Gurjas2112/CHOTU/bot_3d_printing/review_report.md

# Automatic FDM design review - CHOTU v3

Generated by `tools/cad_pipeline.py` after every build (checklist from the Towards AI *cad-skill* workflow: watertight, bed fit, flat bottom, wall thickness, overhangs).

| Part | Qty | Size (mm) | Watertight | Bed fit | Flat bottom (mm²) | Overhang >45° (mm²) | Supports | Est. PETG (g) | Est. time (h) | Result |
|---|---|---|---|---|---|---|---|---|---|---|
| bumper_front | 1 | 51×217×174 | ✔ | ✔ | 427 | 323 | 2627 | yes (see note) | 80 | 7.3 | PASS |
| bumper_left | 1 | 217×51×174 | ✔ | ✔ | 427 | 99 | 2578 | none | 83 | 7.5 | PASS |
| bumper_rear | 1 | 51×217×174 | ✔ | ✔ | 427 | 113 | 2651 | none | 82 | 7.5 | PASS |
| bumper_right | 1 | 217×51×174 | ✔ | ✔ | 427 | 99 | 2578 | none | 83 | 7.5 | PASS |
| lid_tile_1 | 1 | 150×150×3 | ✔ | ✔ | 12193 | 0 | 0 | none | 46 | 4.2 | PASS |
| lid_tile_2 | 1 | 150×150×4 | ✔ | ✔ | 15933 | 0 | 0 | none | 61 | 5.5 | PASS |
| lid_tile_3 | 1 | 150×150×3 | ✔ | ✔ | 15933 | 0 | 0 | none | 61 | 5.5 | PASS |
| lid_tile_4 | 1 | 150×150×3 | ✔ | ✔ | 12193 | 0 | 0 | none | 46 | 4.2 | PASS |
| suction_nozzle | 1 | 36×200×39 | ✔ | ✔ | 1232 | 0 | 2148 | none | 28 | 2.6 | PASS |
| dust_bin | 1 | 100×90×70 | ✔ | ✔ | 8057 | 61 | 4 | none | 43 | 3.9 | PASS |
| bin_filter_lid | 1 | 100×90×28 | ✔ | ✔ | 568 | 0 | 8182 | none | 26 | 2.4 | PASS |
| bin_cradle | 1 | 104×113×40 | ✔ | ✔ | 1127 | 78 | 0 | none | 31 | 2.8 | PASS |
| motor_bracket_left | 1 | 40×48×21 | ✔ | ✔ | 1502 | 14 | 905 | none | 9 | 0.8 | PASS |
| motor_bracket_right | 1 | 40×48×21 | ✔ | ✔ | 1502 | 14 | 905 | none | 9 | 0.8 | PASS |
| caster_spacer | 1 | 32×32×18 | ✔ | ✔ | 695 | 0 | 0 | none | 12 | 1.1 | PASS |
| side_brush_mount | 1 | 30×30×26 | ✔ | ✔ | 882 | 0 | 18 | none | 12 | 1.1 | PASS |
| cliff_mount_left | 1 | 16×36×22 | ✔ | ✔ | 567 | 0 | 0 | none | 6 | 0.5 | PASS |
| cliff_mount_right | 1 | 16×36×22 | ✔ | ✔ | 567 | 0 | 0 | none | 6 | 0.5 | PASS |
| battery_tray | 1 | 76×61×12 | ✔ | ✔ | 4440 | 0 | 240 | none | 18 | 1.6 | PASS |
| camera_pod | 1 | 26×32×26 | ✔ | ✔ | 569 | 112 | 114 | none | 14 | 1.2 | PASS |
| deck_pillar_1 | 1 | 12×12×40 | ✔ | ✔ | 75 | 8 | 0 | none | 4 | 0.4 | PASS |
| deck_pillar_2 | 1 | 12×12×40 | ✔ | ✔ | 75 | 8 | 0 | none | 4 | 0.4 | PASS |
| deck_pillar_3 | 1 | 12×12×40 | ✔ | ✔ | 75 | 8 | 0 | none | 4 | 0.4 | PASS |
| deck_pillar_4 | 1 | 12×12×40 | ✔ | ✔ | 75 | 8 | 0 | none | 4 | 0.4 | PASS |
| electronics_deck | 1 | 100×160×9 | ✔ | ✔ | 14840 | 0 | 27 | none | 60 | 5.4 | PASS |
| bin_hatch | 1 | 117×107×5 | ✔ | ✔ | 10169 | 0 | 168 | none | 57 | 5.2 | PASS |
| rear_skid | 1 | 18×18×34 | ✔ | ✔ | 245 | 0 | 9 | none | 7 | 0.6 | PASS |
| dock_station | 1 | 90×200×110 | ✔ | ✔ | 18000 | 10 | 61 | none | 110 | 10.0 | PASS |

**Totals:** 28 printed parts, ≈ 1007 g PETG (≈ ₹1007 at ₹1/g), ≈ 92 h on a 0.4 mm nozzle at 0.2 mm layers.

All parts pass: **True**. *Bridges* are flat ceilings designed to span less than 20 mm (printable without supports). *Steep overhang* is surface between 45 deg and horizontal: on `bumper_front` it is the upper half of the six 16.6 mm transducer holes and the ToF window, which print cleanly without supports at 0.2 mm layers.
