Gurjas2112/CHOTU/docs/ARCHITECTURE.md

# CHOTU v3: System Architecture

## 1. Block diagram

```mermaid
flowchart LR
  subgraph Power["Power - 3S4P Li-ion 11.1 V / 10 Ah (111 Wh) + 3S BMS"]
    BATT[Battery pack] --> FUSE[Fuse + switch]
    FUSE --> BUCK5[5 V / 5 A buck<br/>Raspberry Pi 4]
    FUSE --> TB[TB6612FNG motor driver]
    FUSE --> MOS1[IRLZ44N - vacuum]
    FUSE --> MOS2[IRLZ44N - side brushes]
  end

  subgraph Pi["Raspberry Pi 4 (4 GB) - ROS 2 Humble in Docker"]
    BRIDGE[serial_bridge_node<br/>odom + TF + sensor topics]
    MISSION[mission_manager_node<br/>chotu_core.CleaningMission]
    YOLO[yolo_detector_node<br/>YOLOv8n suck/avoid]
    CAM[v4l2_camera]
    CAM --> YOLO --> MISSION
    BRIDGE --> MISSION --> BRIDGE
  end

  subgraph MCU["ESP32-S3 DevKitC-1 - real-time base controller (50 Hz)"]
    PID[Wheel PID + feed-forward]
    SAFE[Safety supervisor<br/>watchdog / bump / cliff / ToF]
    SENS[Sensor drivers]
  end

  BRIDGE <-- "UART 115200<br/>COBS + CRC16" --> MCU
  PID --> TB --> MOT[2x BO gear motor<br/>+ 20-slot encoders]
  MOT -- ticks --> PID
  SAFE --> MOS1 --> VAC[Bergmann tornado<br/>12 V vacuum]
  SAFE --> MOS2 --> BRUSH[Brush motors]
  US[3x HC-SR04] --> SENS
  TOF[VL53L0X ToF] --> SENS
  IMU[MPU6050 gyro] --> SENS
  BUMP[SW-420 bump] --> SENS
  CLIFF[2x TCRT5000 cliff] --> SENS
  DOCKIR[TSOP38238 dock IR] --> SENS
  PICAM[Pi camera 5 MP] --> CAM

  subgraph Clients["Off-robot (demo data today)"]
    APP[Flutter app]
    API[FastAPI fleet backend<br/>+ PostgreSQL]
  end
  APP <-- "rosbridge v2 JSON<br/>ws://pi:9090" --> Pi
  API <-- "rosbridge v2 JSON" --> Pi
  APP <-- "REST + WebSocket /api/v1" --> API
```

All the robot's autonomy runs on board. The app and the backend are clients. If WiFi or the backend fails, the mission still completes and the robot still docks.

## 2. Software layers

| Layer | Where | Rate | Code |
|---|---|---|---|
| Motor PWM, encoder ISR, wheel PID, ultrasonic ISR, safety watchdog | ESP32-S3 | 50 Hz (ISRs async) | `firmware/esp32s3_base_controller/src/main.cpp` |
| Wire protocol, PID, safety rules (host-testable) | ESP32-S3 + host g++ | – | `firmware/.../lib/chotu_logic/src/chotu_logic.h` |
| Serial bridge, odometry (encoder + gyro), TF, sensor topics | Pi 4 | 50 Hz | `ros2_ws/src/chotu_base` |
| Mission FSM, mapping, coverage, A*, reactive safety, adaptive suction | Pi 4 | 20 Hz | `chotu_core/*` via `chotu_navigation/mission_manager_node.py` |
| Suck/avoid detection + floor projection | Pi 4 (CPU, NCNN) / RTX 3060 (CUDA) | 5 FPS | `chotu_core/perception.py`, `chotu_perception` |
| Gazebo world (physics simulation) + recorder | Workstation (Docker) | 500 Hz physics | `chotu_gazebo`, `chotu_bringup/launch/sim.launch.py`, `bot_simulation/gazebo_recording/` |
| App API (start / dock / no-go zones / status) | Pi 4 | 5 Hz status | `rosbridge_websocket` in `robot.launch.py` |
| Mobile app (control, live map, schedules, history) | Phone | – | `mobile_app/chotu_app` (Flutter) |
| Fleet backend (history, schedules, zones, alerts, live relay) | Server / workstation | 1 Hz relay | `backend/chotu_api` (FastAPI + SQLAlchemy) |

## 3. Mission state machine

```mermaid
stateDiagram-v2
  [*] --> IDLE
  IDLE --> UNDOCK: /chotu/start_mission
  UNDOCK --> SCAN: 0.45 m from dock
  SCAN --> COVER: 360 deg sweep done
  COVER --> SPOT_CLEAN: lane waypoints exhausted
  COVER --> STUCK_RECOVERY: blocked > 1.5 s / no progress 5 s
  SPOT_CLEAN --> STUCK_RECOVERY
  STUCK_RECOVERY --> COVER: reverse + VFH turn
  STUCK_RECOVERY --> SPOT_CLEAN
  COVER --> RETURN_TO_DOCK: time_left < ETA + margin / low battery / app "Dock"
  SPOT_CLEAN --> RETURN_TO_DOCK: room complete / time
  RETURN_TO_DOCK --> DOCKING: at approach point
  DOCKING --> DOCKED: contacts (< 3 cm)
  DOCKED --> [*]
```

## 4. Autonomy algorithms (chotu_core)

* **Odometry** (`kinematics.py`). The encoders are single-channel, so direction comes from the command sign. Heading is fused with the MPU6050 gyro (complementary filter, 0.98 gyro). The gyro bias is calibrated on the dock at boot.
* **Mapping** (`occupancy_grid.py`). A 5 cm log-odds grid. HC-SR04 echoes are integrated over their **15° cone** (three rays). The cone edges carry weaker free-space evidence, so thin chair legs survive. Echoes explained by the **known room walls** are not mapped. The camera's *avoid* detections become permanent keep-out discs.
* **Coverage** (`coverage_planner.py`, `autonomy.py`). Boustrophedon lanes 22 cm apart give 2 cm of overlap for a 24 cm head. The next waypoint is picked greedily with an anisotropic cost (along-lane 1, lane change 2.5, reversing +0.6). That finishes the region the robot is in before crossing over, which works like an online cell decomposition. Leftover pockets are found with connected components (*frontier fill*).
* **Planning** (`path_planner.py`). 8-connected A* on a two-tier map: **hard** cells are physically impossible, **soft** cells are the clearance band. Soft cells are allowed only inside an *escape disc* around the robot, so it can always plan its way out but is never routed between chair legs. Paths are string-pulled for line of sight.
* **Reactive safety** (`obstacle_avoidance.py`). Every echo is projected onto the round chassis' swept corridor. A wall *beside* the robot no longer blocks it, but a chair leg *ahead* does. The firmware enforces the same stop rules independently.
* **Time-aware return.** Every second the robot plans an A* path home and estimates the ETA at 75 % of top speed. It leaves for the dock when `time_left < ETA + 14 s`.
* **User no-go zones** (`autonomy.add_no_go`, `OccupancyGrid.mark_rect`). Rectangles drawn in the app arrive through `/chotu/set_zones` and become permanent keep-out cells. They are excluded from coverage and avoided by A*.
* **Operator dock** (`autonomy.request_dock`). The app's *Dock* button is `StartMission{abort: true}`. From any cleaning state the robot plans home with A* and finishes with the normal IR docking.
* **Adaptive suction** (`suction_controller.py`). ECO is 55 % and BOOST is 100 % for 1.2 s after debris is detected ahead. Fan power scales with duty^1.5.

## 5. Pi ↔ ESP32 protocol

Each frame is `COBS(payload ‖ CRC16-CCITT) ‖ 0x00`, where the payload is `msg_id:u8, seq:u8, body` (little-endian).

| ID | Direction | Body |
|---|---|---|
| `0x01` CMD_VEL | Pi → ESP | `i16 v_mm_s, i16 w_mrad_s` |
| `0x02` ACTUATORS | Pi → ESP | `u8 suction_pct, u8 brush_pct` |
| `0x03` HEARTBEAT | Pi → ESP | – (feeds the 300 ms watchdog) |
| `0x04` ESTOP | Pi → ESP | `u8 engage` |
| `0x81` TELEMETRY | ESP → Pi | `u32 t_ms, i32 ticks_l, i32 ticks_r, i16 gyro_z_mrad_s, u16 us_l, us_c, us_r, tof (mm), u8 flags, u16 batt_mv` (25 B) |

The flag bits are bump (0), cliff L (1), cliff R (2), e-stop (3), watchdog (4) and dock IR seen (5). Python (`chotu_core/protocol.py`) and C++ (`chotu_logic.h`) are tested against the **same byte vectors**.

## 6. ESP32-S3 DevKitC-1 pin map

| Function | GPIO | Notes |
|---|---|---|
| TB6612FNG PWMA / AIN1 / AIN2 (left) | 4 / 5 / 6 | 20 kHz, 10-bit PWM |
| TB6612FNG PWMB / BIN1 / BIN2 (right) | 7 / 15 / 16 | |
| TB6612FNG STBY | 2 | LOW = both channels off. A 10 k pull-down keeps the motors off at boot, and e-stop drives it LOW. |
| Encoder L / R | 17 / 18 | LM393 slot sensor, 20 slots, **5 V → 1 k / 2 k divider on the PCB** |
| I2C SDA / SCL | 8 / 9 | VL53L0X (0x29) + MPU6050 (0x68), 400 kHz |
| VL53L0X XSHUT | 47 | |
| HC-SR04 L trig/echo | 10 / 13 | **echo is 5 V → 1k/2k divider** |
| HC-SR04 C trig/echo | 11 / 14 | |
| HC-SR04 R trig/echo | 12 / 21 | |
| SW-420 bump | 38 | interrupt, rising edge |
| Cliff IR L / R | 39 / 40 | HIGH = no floor |
| Dock IR (TSOP38238) | 3 | LOW = 38 kHz beacon seen (input only, so the strapping function is unaffected) |
| Vacuum MOSFET / Brush MOSFET | 41 / 42 | IRLZ44N logic-level, 100 Ω gate, 10 k pull-down, 1N5822 flyback |
| Battery sense | 1 | 100 k / 22 k divider (ADC1) |
| Status LED | 48 | On-board RGB |

We avoided strapping pins 0, 45 and 46 (GPIO3 is used only as an input), USB (19/20), flash and PSRAM (26–37) and UART0 (43/44, the Pi link). The XIAO ESP32-S3 Sense from the original spec sheet has only 11 GPIO, which is too few for this sensor set without an I/O expander. It is retired in v3.

The carrier PCB in `hardware/pcb/` implements exactly this table. `tests/test_pcb_netlist.py` fails if the PCB and `pins.h` ever disagree.

## 7. ROS 2 graph

```
/camera/image_raw ─► yolo_detector_node ─► /chotu/detections ─┐
serial_bridge_node ─► /odom /imu /range/{left,center,right,tof} /chotu/bump /chotu/cliff /battery_state ─► mission_manager_node
mission_manager_node ─► /cmd_vel /chotu/actuators ─► serial_bridge_node ─► ESP32
mission_manager_node ─► /chotu/status /map /chotu/plan  (RViz, dashboards)
services: /chotu/start_mission (StartMission: abort=false starts, abort=true returns to dock)
          /chotu/set_zones     (SetZones: no-go rectangles from the app)
rosbridge_websocket :9090 ─► Flutter app, fleet backend (JSON over WebSocket)
```

In Gazebo, `gz_sensor_adapter_node` replaces `serial_bridge_node` and publishes the **same topics**. The mission node does not know whether it is running in simulation or on hardware.

## 8. Communication protocols (end to end)

| Link | Transport | Format | Spec |
|---|---|---|---|
| ESP32-S3 ↔ Raspberry Pi | UART 115200 over USB | COBS + CRC16-CCITT binary frames, 50 Hz | §5 above, `chotu_core/protocol.py`, `chotu_logic.h` |
| ROS nodes on the Pi | DDS (CycloneDDS, host network) | ROS 2 messages (`chotu_interfaces`) | §7 above |
| App / backend ↔ robot | WebSocket `ws://<pi>:9090` | rosbridge v2 JSON (`subscribe`, `call_service`) | [`backend/PROTOCOL.md`](../backend/PROTOCOL.md) §2 |
| App / dashboard ↔ backend | HTTPS REST `/api/v1` + WebSocket `/ws/v1/robots/{id}` | JSON; versioned envelope `{v, type, robot_id, seq, ts, data}` | [`backend/PROTOCOL.md`](../backend/PROTOCOL.md) §3–4 |
| Backend ↔ database | TCP 5432 | SQL via SQLAlchemy (PostgreSQL) | [`backend/migrations/001_init.sql`](../backend/migrations/001_init.sql) |
