Gurjas2112/CHOTU/hardware/pcb/protoflow/PROTOFLOW_BRIEF.md

# Protoflow brief - CHOTU carrier PCB v3

Paste everything below the line into Protoflow's chat. Generated by
`make_protoflow_package.py` from `hardware/pcb/chotu_carrier.py` - do not edit by hand.

---

Design a **2-layer, 1.6 mm FR-4 carrier PCB, 90 x 65 mm**, four M3 mounting holes 4 mm in from each corner
(they match the 3D-printed electronics deck in bot_3d_printing). It is the base-controller board of CHOTU, an
autonomous floor-cleaning robot: an **ESP32-S3-DevKitC-1 plugs into two 1x22 2.54 mm female headers**
(J1 left / J3 right, 25.4 mm row spacing) and every other module connects through JST-XH connectors on the
board edge. Fabrication target: **JLCPCB**, SMD passives 0805 from the JLC basic library, THT for connectors,
TO-220 MOSFETs and DO-201AD diodes. Hand-solderable.

## Electrical rules
- Power nets carrying motor/vacuum current - VBAT_RAW, VBAT_SW, VBAT, GND, VACUUM_D, BRUSH_D, MOT_* - use
  **2.0 mm traces** (vacuum branch peaks ~5 A); +5V 1.0 mm; all signals 0.3 mm. 0.2 mm min clearance.
- **Star ground**: the motor/vacuum return (Q1/Q2 sources, TB6612 GND, C1) meets logic ground at a single point
  next to J1 (XT60). Pour GND on the bottom layer.
- Keep Q1/Q2, D1/D2 and J17/J18 on one board edge away from the ESP32 antenna end (no copper under the antenna).
- C2 (1000 uF) within 10 mm of U2's OUT pads; C1 within 10 mm of J1.
- 5 V outputs of the HC-SR04 echoes and LM393 encoders must only reach the ESP32 through their 1k/2k dividers
  (nets *_ECHO_5V / ENC_*_5V never touch U1).
- Run ERC and DRC, then export Gerbers, drill, BOM, CPL (pick-and-place) and STEP for JLCPCB.

## Parts
| Ref | Value | Footprint |
|---|---|---|
| J1 | XT60 battery 3S 11.1V | `Connector_AMASS:AMASS_XT60-M_1x02_P7.20mm_Vertical` |
| F1 | Fuse 10A ATO | `Fuse:Fuseholder_Blade_ATO_Littelfuse_FLR_178.6165` |
| J2 | Rocker switch (panel) | `Connector_JST:JST_XH_B2B-XH-A_1x02_P2.50mm_Vertical` |
| C1 | 470uF 25V | `Capacitor_THT:CP_Radial_D10.0mm_P5.00mm` |
| U2 | XL4015 5V/5A buck module | `CHOTU:XL4015_module_pads` |
| C2 | 1000uF 10V | `Capacitor_THT:CP_Radial_D10.0mm_P5.00mm` |
| J3 | Raspberry Pi 4 5V feed (GPIO pins 2/6) | `Connector_JST:JST_XH_B2B-XH-A_1x02_P2.50mm_Vertical` |
| U1 | ESP32-S3-DevKitC-1 (N8R8) | `CHOTU:ESP32-S3-DevKitC-1_2x22_socket` |
| U3 | TB6612FNG module | `CHOTU:TB6612FNG_module_2x8` |
| R1 | 10k | `Resistor_SMD:R_0805_2012Metric` |
| J4 | Left BO motor | `Connector_JST:JST_XH_B2B-XH-A_1x02_P2.50mm_Vertical` |
| J5 | Right BO motor | `Connector_JST:JST_XH_B2B-XH-A_1x02_P2.50mm_Vertical` |
| J6 | Encoder L (LM393) | `Connector_JST:JST_XH_B3B-XH-A_1x03_P2.50mm_Vertical` |
| R2 | 1k | `Resistor_SMD:R_0805_2012Metric` |
| R3 | 2k | `Resistor_SMD:R_0805_2012Metric` |
| J7 | Encoder R (LM393) | `Connector_JST:JST_XH_B3B-XH-A_1x03_P2.50mm_Vertical` |
| R4 | 1k | `Resistor_SMD:R_0805_2012Metric` |
| R5 | 2k | `Resistor_SMD:R_0805_2012Metric` |
| J8 | HC-SR04 L | `Connector_JST:JST_XH_B4B-XH-A_1x04_P2.50mm_Vertical` |
| R6 | 1k | `Resistor_SMD:R_0805_2012Metric` |
| R7 | 2k | `Resistor_SMD:R_0805_2012Metric` |
| J9 | HC-SR04 C | `Connector_JST:JST_XH_B4B-XH-A_1x04_P2.50mm_Vertical` |
| R8 | 1k | `Resistor_SMD:R_0805_2012Metric` |
| R9 | 2k | `Resistor_SMD:R_0805_2012Metric` |
| J10 | HC-SR04 R | `Connector_JST:JST_XH_B4B-XH-A_1x04_P2.50mm_Vertical` |
| R10 | 1k | `Resistor_SMD:R_0805_2012Metric` |
| R11 | 2k | `Resistor_SMD:R_0805_2012Metric` |
| J11 | VL53L0X ToF | `Connector_JST:JST_XH_B5B-XH-A_1x05_P2.50mm_Vertical` |
| J12 | MPU6050 IMU | `Connector_JST:JST_XH_B4B-XH-A_1x04_P2.50mm_Vertical` |
| R12 | 4.7k | `Resistor_SMD:R_0805_2012Metric` |
| R13 | 4.7k | `Resistor_SMD:R_0805_2012Metric` |
| J13 | SW-420 bump | `Connector_JST:JST_XH_B3B-XH-A_1x03_P2.50mm_Vertical` |
| J14 | TCRT5000 cliff L | `Connector_JST:JST_XH_B3B-XH-A_1x03_P2.50mm_Vertical` |
| J15 | TCRT5000 cliff R | `Connector_JST:JST_XH_B3B-XH-A_1x03_P2.50mm_Vertical` |
| J16 | TSOP38238 dock IR | `Connector_JST:JST_XH_B3B-XH-A_1x03_P2.50mm_Vertical` |
| R14 | 100R | `Resistor_SMD:R_0805_2012Metric` |
| C3 | 4.7uF | `Capacitor_SMD:C_0805_2012Metric` |
| Q1 | IRLZ44N | `Package_TO_SOT_THT:TO-220-3_Vertical` |
| R15 | 100R | `Resistor_SMD:R_0805_2012Metric` |
| R16 | 10k | `Resistor_SMD:R_0805_2012Metric` |
| D1 | 1N5822 | `Diode_THT:D_DO-201AD_P15.24mm_Horizontal` |
| J17 | Bergmann BAV-60 vacuum 12V/60W | `Connector_AMASS:AMASS_XT30PW-M_1x02_P2.50mm_Horizontal` |
| Q2 | IRLZ44N | `Package_TO_SOT_THT:TO-220-3_Vertical` |
| R17 | 100R | `Resistor_SMD:R_0805_2012Metric` |
| R18 | 10k | `Resistor_SMD:R_0805_2012Metric` |
| D2 | 1N5822 | `Diode_THT:D_DO-201AD_P15.24mm_Horizontal` |
| J18 | Side-brush motor 12V | `Connector_JST:JST_XH_B2B-XH-A_1x02_P2.50mm_Vertical` |
| R19 | 100k | `Resistor_SMD:R_0805_2012Metric` |
| R20 | 22k | `Resistor_SMD:R_0805_2012Metric` |
| C4 | 100nF | `Capacitor_SMD:C_0805_2012Metric` |
| TP1 | TP VBAT | `TestPoint:TestPoint_Pad_D2.0mm` |
| TP2 | TP +5V | `TestPoint:TestPoint_Pad_D2.0mm` |
| TP3 | TP +3V3 | `TestPoint:TestPoint_Pad_D2.0mm` |
| TP4 | TP GND | `TestPoint:TestPoint_Pad_D2.0mm` |

## Netlist (every connection)
| Net | Pins (ref.pin-name) |
|---|---|
| +3V3 | U1.3V3, U1.3V3, U3.VCC, J11.VIN, J12.VCC, R12.1, R13.1, J13.VCC, J14.VCC, J15.VCC, R14.1, TP3.1 |
| +5V | U2.OUT+, C2.1, J3.5V, U1.5V0, J6.VCC, J7.VCC, J8.VCC, J9.VCC, J10.VCC, TP2.1 |
| BATT_SENSE | U1.GPIO1, R19.2, R20.1, C4.1 |
| BRUSH_D | Q2.D, D2.A, J18.- |
| BRUSH_G | Q2.G, R17.2, R18.1 |
| BRUSH_PWM | U1.GPIO42, R17.1 |
| CLIFF_L | U1.GPIO39, J14.DO |
| CLIFF_R | U1.GPIO40, J15.DO |
| DOCK_IR | U1.GPIO3, J16.OUT |
| ENC_L | U1.GPIO17, R2.2, R3.1 |
| ENC_L_5V | J6.OUT, R2.1 |
| ENC_R | U1.GPIO18, R4.2, R5.1 |
| ENC_R_5V | J7.OUT, R4.1 |
| GND | J1.BAT-, C1.2, U2.IN-, U2.OUT-, C2.2, J3.GND, U1.GND, U1.GND, U1.GND, U1.GND, U3.GND, U3.GND, U3.GND, R1.2, J6.GND, R3.2, J7.GND, R5.2, J8.GND, R7.2, J9.GND, R9.2, J10.GND, R11.2, J11.GND, J12.GND, J13.GND, J14.GND, J15.GND, J16.GND, C3.2, Q1.S, R16.2, Q2.S, R18.2, R20.2, C4.2, TP4.1 |
| I2C_SCL | U1.GPIO9, J11.SCL, J12.SCL, R12.2 |
| I2C_SDA | U1.GPIO8, J11.SDA, J12.SDA, R13.2 |
| MOTOR_L_EN | U1.GPIO4, U3.PWMA |
| MOTOR_L_IN1 | U1.GPIO5, U3.AIN1 |
| MOTOR_L_IN2 | U1.GPIO6, U3.AIN2 |
| MOTOR_R_EN | U1.GPIO7, U3.PWMB |
| MOTOR_R_IN3 | U1.GPIO15, U3.BIN1 |
| MOTOR_R_IN4 | U1.GPIO16, U3.BIN2 |
| MOTOR_STBY | U1.GPIO2, U3.STBY, R1.1 |
| MOT_L_A | U3.AO1, J4.1 |
| MOT_L_B | U3.AO2, J4.2 |
| MOT_R_A | U3.BO1, J5.1 |
| MOT_R_B | U3.BO2, J5.2 |
| SW420 | U1.GPIO38, J13.DO |
| TOF_XSHUT | U1.GPIO47, J11.XSHUT |
| TSOP_VS | J16.VS, R14.2, C3.1 |
| US_C_ECHO | U1.GPIO14, R8.2, R9.1 |
| US_C_ECHO_5V | J9.ECHO, R8.1 |
| US_C_TRIG | U1.GPIO11, J9.TRIG |
| US_L_ECHO | U1.GPIO13, R6.2, R7.1 |
| US_L_ECHO_5V | J8.ECHO, R6.1 |
| US_L_TRIG | U1.GPIO10, J8.TRIG |
| US_R_ECHO | U1.GPIO21, R10.2, R11.1 |
| US_R_ECHO_5V | J10.ECHO, R10.1 |
| US_R_TRIG | U1.GPIO12, J10.TRIG |
| VACUUM_D | Q1.D, D1.A, J17.- |
| VACUUM_G | Q1.G, R15.2, R16.1 |
| VACUUM_PWM | U1.GPIO41, R15.1 |
| VBAT | J2.2, C1.1, U2.IN+, U3.VM, D1.K, J17.+, D2.K, J18.+, R19.1, TP1.1 |
| VBAT_RAW | J1.BAT+, F1.1 |
| VBAT_SW | F1.2, J2.1 |

## ESP32-S3 GPIO map (must match firmware include/pins.h)
| Signal | GPIO |
|---|---|
| BATT_SENSE | GPIO1 |
| MOTOR_STBY | GPIO2 |
| DOCK_IR | GPIO3 |
| MOTOR_L_EN | GPIO4 |
| MOTOR_L_IN1 | GPIO5 |
| MOTOR_L_IN2 | GPIO6 |
| MOTOR_R_EN | GPIO7 |
| I2C_SDA | GPIO8 |
| I2C_SCL | GPIO9 |
| US_L_TRIG | GPIO10 |
| US_C_TRIG | GPIO11 |
| US_R_TRIG | GPIO12 |
| US_L_ECHO | GPIO13 |
| US_C_ECHO | GPIO14 |
| MOTOR_R_IN3 | GPIO15 |
| MOTOR_R_IN4 | GPIO16 |
| ENC_L | GPIO17 |
| ENC_R | GPIO18 |
| US_R_ECHO | GPIO21 |
| SW420 | GPIO38 |
| CLIFF_L | GPIO39 |
| CLIFF_R | GPIO40 |
| VACUUM_PWM | GPIO41 |
| BRUSH_PWM | GPIO42 |
| TOF_XSHUT | GPIO47 |

Unused DevKitC pins (RST, GPIO0/45/46 strapping, GPIO19/20 USB, GPIO35-37 PSRAM, GPIO48 RGB LED, TX/RX) are left unconnected.
