Gurjas2112/CHOTU/docs/DEPLOYMENT.md

# Deployment Guide

> The prototype deploys to one Raspberry Pi 4 robot, plus the fleet backend on any Docker host. It runs on demo data until the hardware is bought. Production concerns are listed at the end and deliberately deferred: OTA updates, signed images and certification.

## 1. Release artefacts

| Artefact | Built from | Runs on |
|---|---|---|
| `chotu/runtime:<ver>` (linux/arm64 + amd64) | `docker/Dockerfile --target runtime` | Raspberry Pi 4: serial bridge, mission manager, camera |
| `chotu/perception:<ver>` | `--target perception` | Pi 4 (CPU/NCNN) or a GPU workstation (`--gpus all`) |
| `chotu/dev:<ver>` | `--target dev` | Workstation: build, Gazebo, RViz |
| `chotu/backend:<ver>` | `backend/Dockerfile` | Any Docker host: fleet API + dashboard (port 8000) |
| `firmware.bin` | `pio run -e esp32s3` | ESP32-S3 base controller |
| App APK / web build | `flutter build apk` / `flutter build web` | Android phones / any browser |
| `chotu_suck_avoid_yolov8n_ncnn_model/` | `training/train_suck_avoid.py` | Mounted read-only at `/opt/chotu/models` |

Always tag images with a version (`CHOTU_VERSION=3.0.0`) and never deploy `:latest` to a robot. The 2026 Docker-for-ROS-2 guide makes the same point: it is what allows a confident rollback.

## 2. Pipeline

```mermaid
flowchart LR
  dev[Workstation<br/>Windows 11 + Docker] -->|git push| ci[GitHub Actions<br/>pytest, host tests, PIO build, colcon]
  ci -->|green| build[buildx linux/arm64<br/>runtime + perception]
  build -->|push vX.Y.Z| reg[(Container registry<br/>ghcr.io)]
  reg -->|docker compose pull| pi[Raspberry Pi 4<br/>CHOTU]
  dev -->|pio upload| esp[ESP32-S3]
  esp <-->|UART| pi
```

## 3. Step by step

### 3.1 Firmware
```bash
bash scripts/flash_esp32.sh /dev/ttyUSB0        # or COM5 on Windows
```
Record the firmware git hash next to the image version in the release notes. The protocol is versioned by message IDs, so bump an ID when you change a payload.

### 3.2 Container images (from the workstation)
```bash
export REGISTRY=ghcr.io/<github-user> PI_HOST=ubuntu@chotu.local
echo $GITHUB_TOKEN | docker login ghcr.io -u <github-user> --password-stdin
bash scripts/deploy_pi.sh 3.0.0
```
`deploy_pi.sh` does the following:
1. Builds `runtime` and `perception` for **linux/arm64** with buildx and pushes them.
2. Copies `docker-compose.yml` to the Pi.
3. Runs `docker compose --profile robot pull && up -d` on the Pi.

### 3.3 Model weights
```bash
scp -r models/chotu_suck_avoid_yolov8n_ncnn_model ubuntu@chotu.local:~/chotu/models/
```

### 3.4 Start on boot
The compose services use `restart: unless-stopped`, so the stack comes back after a power cycle. To start cleaning automatically, for competition mode, edit `chotu_params.yaml` so that `chotu_mission_manager.auto_start: true`. Alternatively, trigger it from a phone or laptop on the same network:
```bash
ros2 service call /chotu/start_mission chotu_interfaces/srv/StartMission "{abort: false, time_budget_s: 300.0}"
```

### 3.5 Verify on the robot
```bash
docker compose --profile robot ps
docker compose --profile robot logs -f robot          # "CHOTU mission manager ready"
docker exec -it chotu-robot-1 bash -lc "ros2 topic hz /odom"
```

### 3.6 Roll back
```bash
CHOTU_VERSION=2.0.0 docker compose --profile robot up -d     # previous tag
```

## 4. Debugging routine (from the Docker-for-ROS-2 guide)
Check each layer in this order before suspecting ROS code:
1. `docker ps`: is the container running?
2. `docker logs <c>`: did a process crash?
3. `docker exec -it <c> bash`: are the files, devices (`/dev/ttyUSB0`, `/dev/video0`) and models there?
4. Is ROS sourced? (`echo $ROS_DISTRO`, `ros2 pkg list | grep chotu`)
5. Is the cause networking (DDS domain, host network), hardware (wiring, power, watchdog flag) or display (`DISPLAY`, X11 socket)?

## 5. Competition-day checklist (AtomQuest finale format)
- [ ] Battery above 12.2 V, dust container emptied and latched
- [ ] Room size and dock position entered in `chotu_params.yaml`
- [ ] Robot placed on the dock and powered **still** (gyro calibration; the app shows *Docked · ready*)
- [ ] `ros2 topic echo /chotu/status --once` shows `IDLE`, battery state OK
- [ ] Use the 1-minute inspection to note low objects (cables), then trust the camera keep-outs
- [ ] Start the service call and the stopwatch together; keep the e-stop ready (`ros2 topic pub /chotu/estop std_msgs/Bool "{data: true}" --once`)

## 6. Deferred to production (intentionally not done yet)
* A molded enclosure, IP rating and EMC certification of the vacuum motor and drivers
* Signed images, secure boot and OTA (for example Mender or balena) with A/B partitions
* Managed PostgreSQL with backups, TLS termination and per-user auth for the fleet backend (the prototype uses one API key)
* PCB fabrication and assembly: the board is designed and checked (`hardware/pcb/`), but no Gerbers have been ordered yet
* LiDAR SLAM (`slam_toolbox`) for multi-room homes

## 7. Fleet backend

```bash
# sample data (no database): API + dashboard on :8000
docker compose -f backend/docker-compose.yml up -d --build
# PostgreSQL: schema from backend/migrations, seeded from backend/sample_data
CHOTU_STORE=sql CHOTU_API_KEY=$(openssl rand -hex 24) \
  docker compose -f backend/docker-compose.yml --profile db up -d --build
# talk to real robots instead of the demo replay
CHOTU_ROBOT_LINK=rosbridge ...   # each robot's ws://<pi>:9090 comes from the robots table
```
The robot never depends on the backend. If the backend is down, the app still controls the robot directly over rosbridge on the local network.
