Gurjas2112/CHOTU/backend/docs/app_settings_backend.png

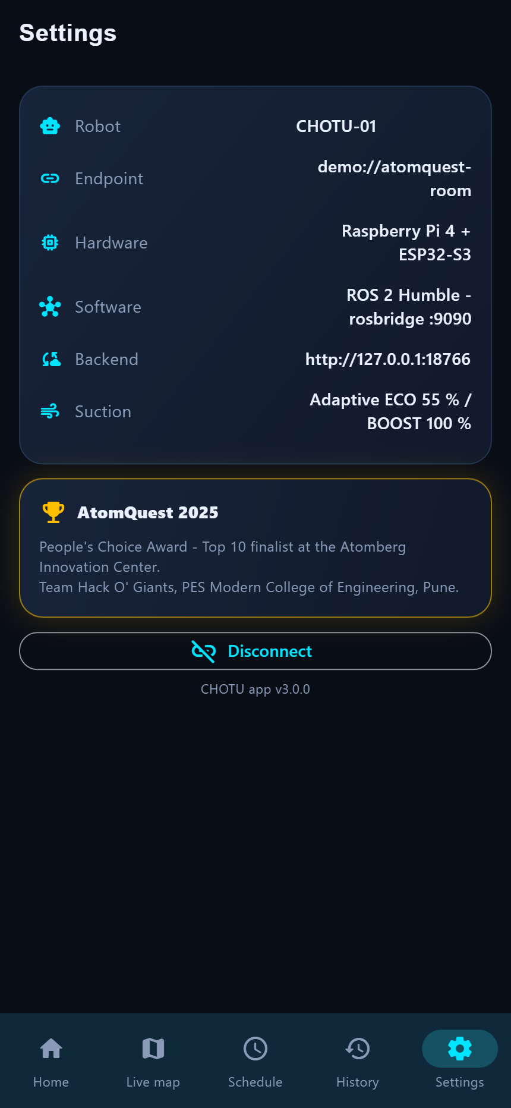
backend/docs/app_settings_backend.png
