Gurjas2112/CHOTU/bot_3d_printing/previews/electronics_deck_4view.png

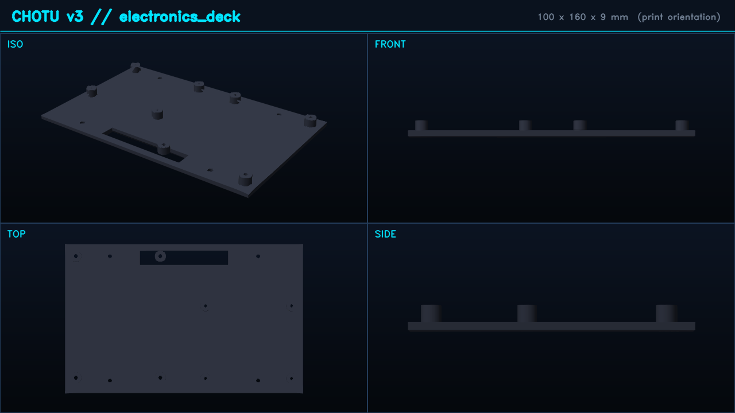
bot_3d_printing/previews/electronics_deck_4view.png
