Gurjas2112/CHOTU/bot_simulation/simulation_screenshot_screen_recording/01_mission_start_docked.png

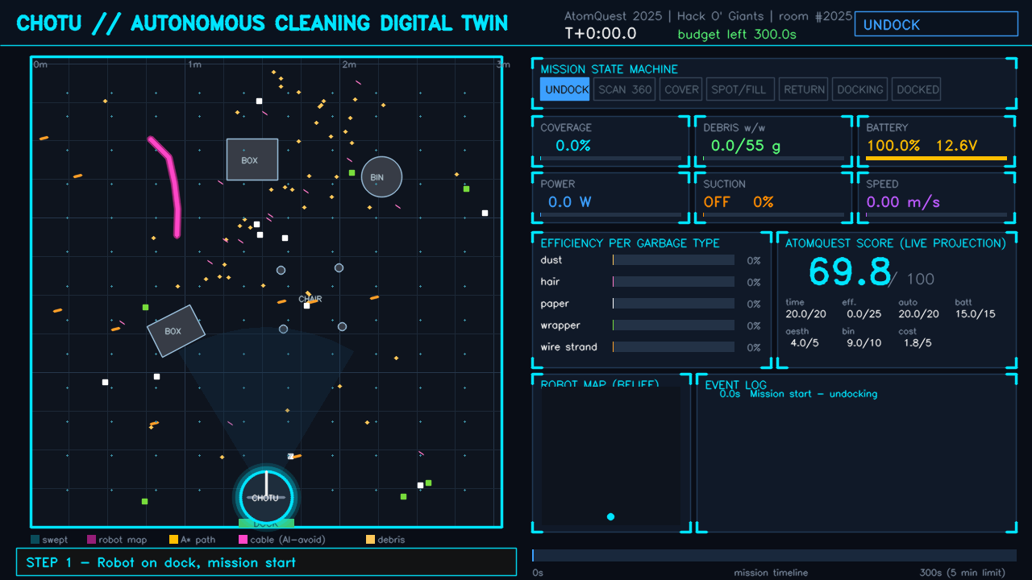
bot_simulation/simulation_screenshot_screen_recording/01_mission_start_docked.png
