Gurjas2112/CHOTU/bot_simulation/simulation_screenshot_screen_recording/03_mapping_scan_360.png

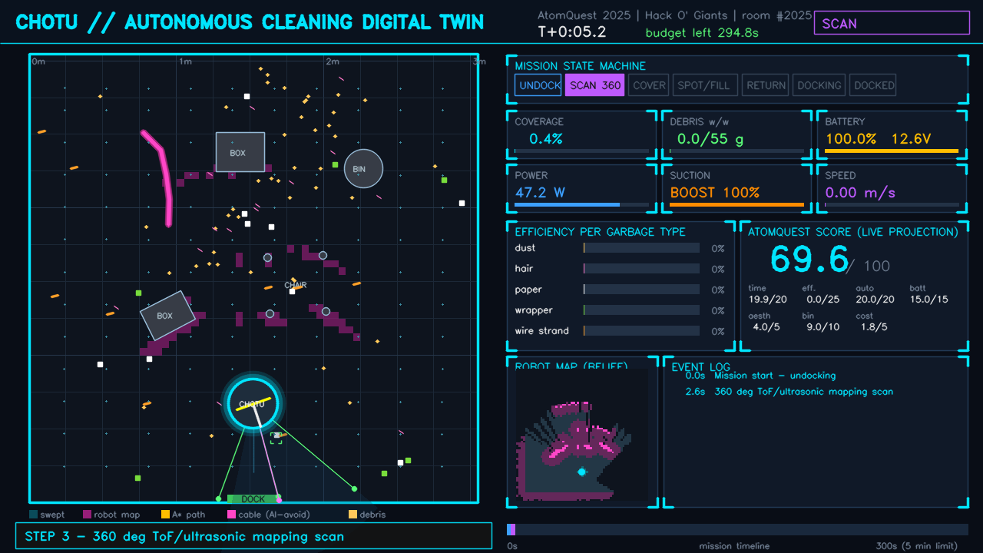
bot_simulation/simulation_screenshot_screen_recording/03_mapping_scan_360.png
