Gurjas2112/CHOTU/bot_simulation/simulation_screenshot_screen_recording/04_adaptive_suction_boost.png

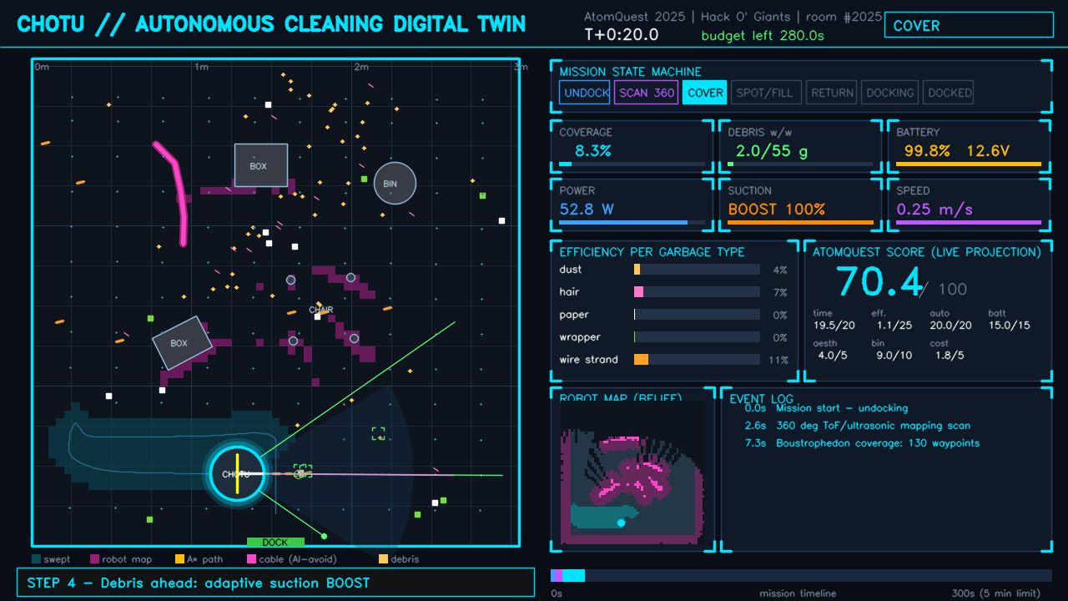
bot_simulation/simulation_screenshot_screen_recording/04_adaptive_suction_boost.png
