Gurjas2112/CHOTU/bot_simulation/simulation_screenshot_screen_recording/06_obstacle_avoidance_reactive.png

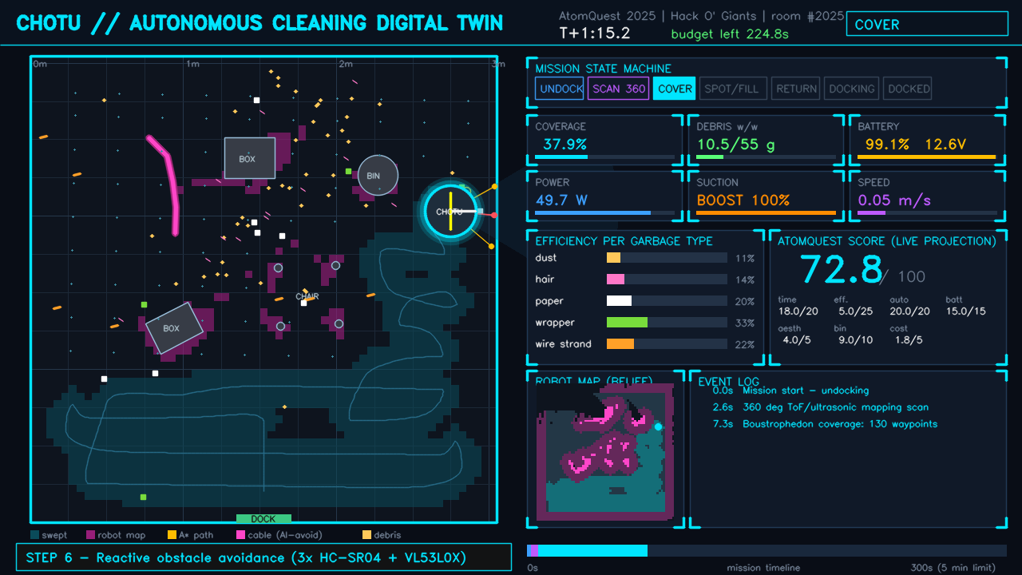
bot_simulation/simulation_screenshot_screen_recording/06_obstacle_avoidance_reactive.png
