Gurjas2112/CHOTU/bot_simulation/simulation_screenshot_screen_recording/08_spot_clean_frontier_fill.png

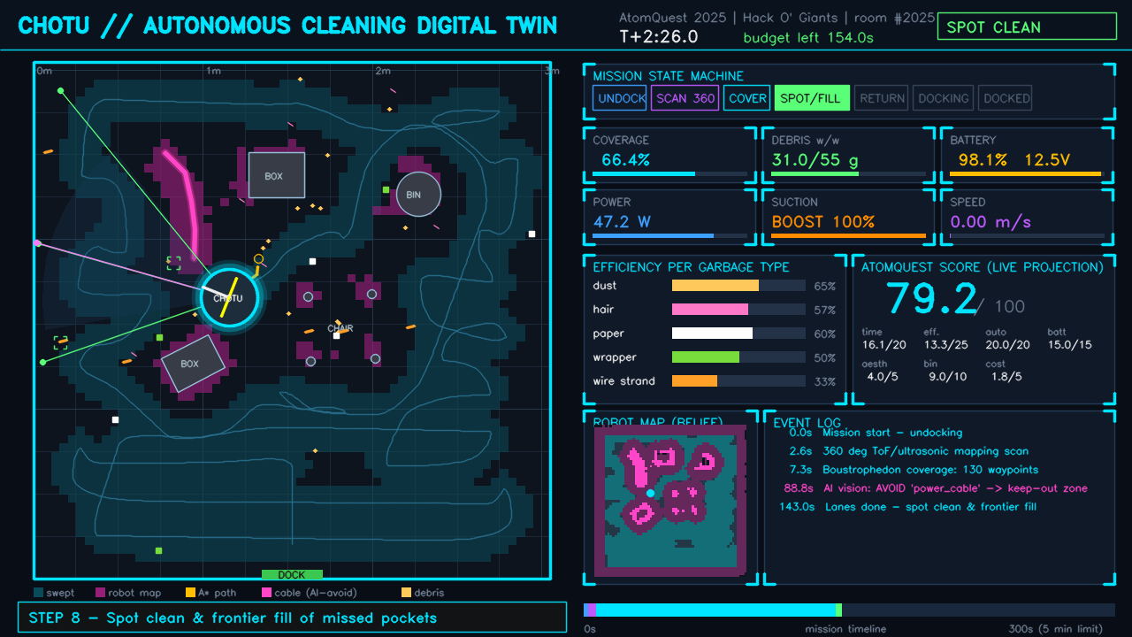
bot_simulation/simulation_screenshot_screen_recording/08_spot_clean_frontier_fill.png
