Gurjas2112/CHOTU/bot_simulation/simulation_screenshot_screen_recording/09_coverage_progress_150s.png

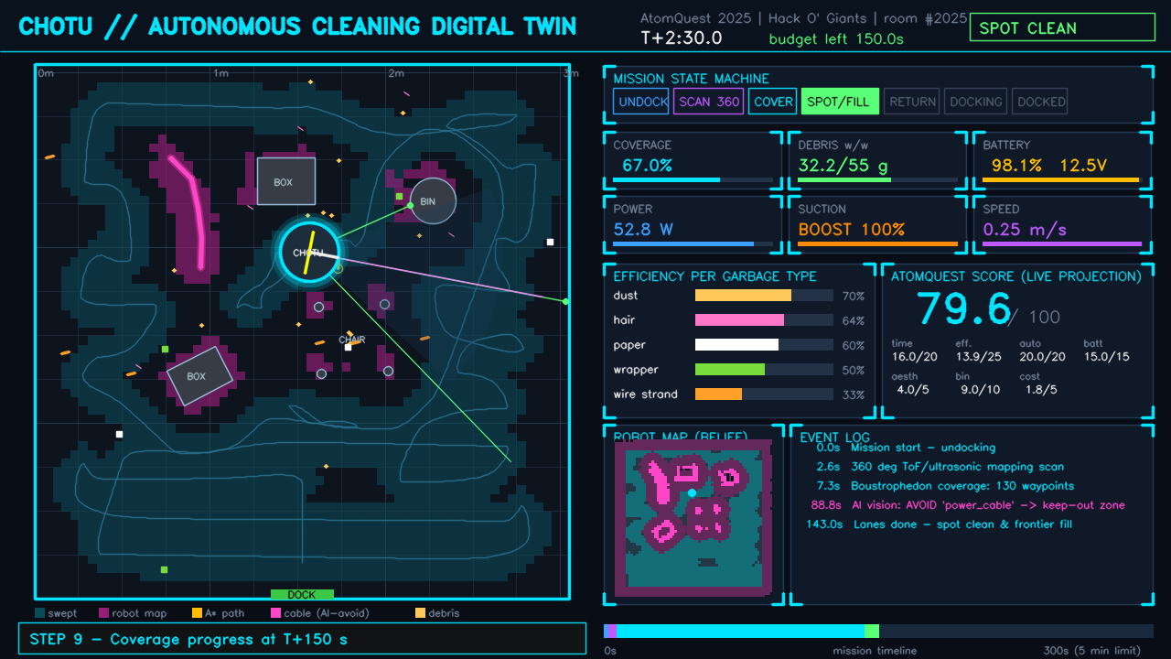
bot_simulation/simulation_screenshot_screen_recording/09_coverage_progress_150s.png
