Gurjas2112/CHOTU/bot_simulation/simulation_screenshot_screen_recording/10_stuck_recovery.png

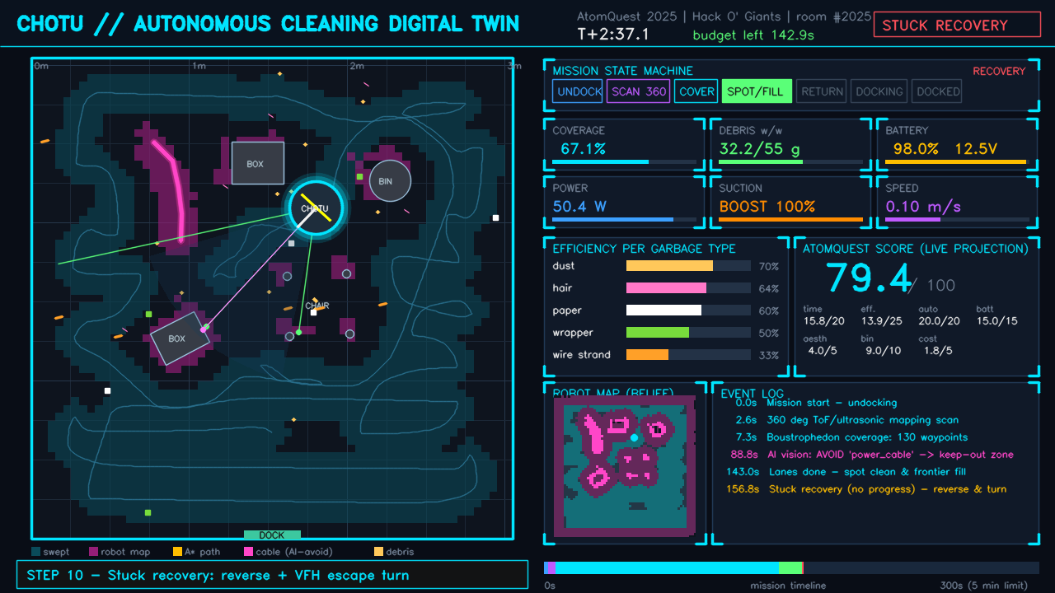
bot_simulation/simulation_screenshot_screen_recording/10_stuck_recovery.png
