Gurjas2112/CHOTU/bot_simulation/simulation_screenshot_screen_recording/11_return_to_dock_astar.png

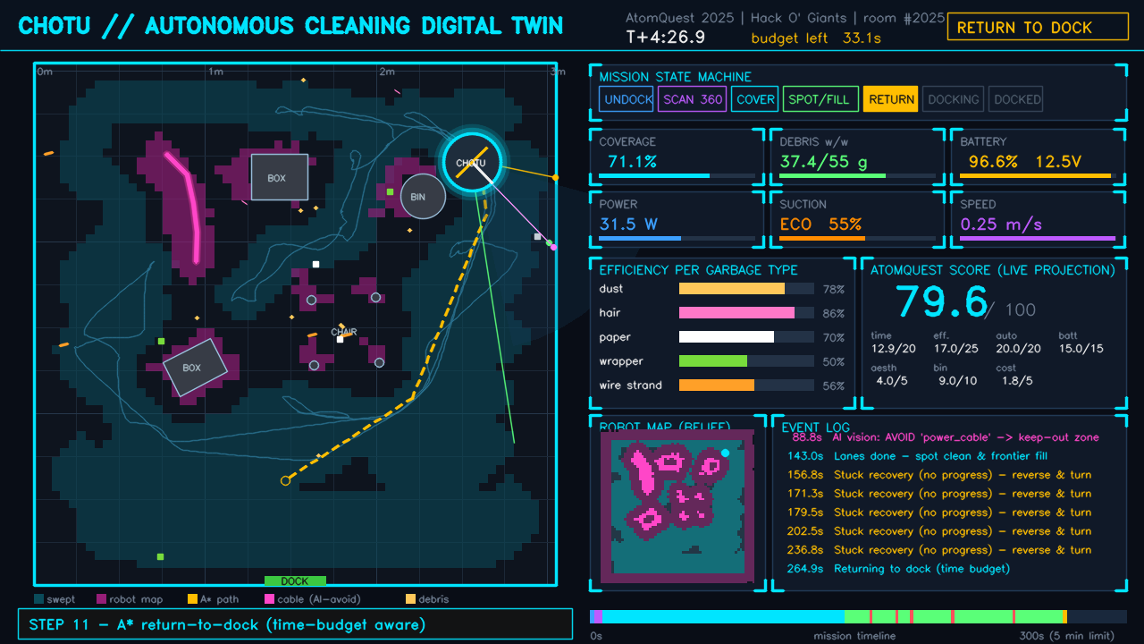
bot_simulation/simulation_screenshot_screen_recording/11_return_to_dock_astar.png
