Gurjas2112/CHOTU/bot_simulation/simulation_screenshot_screen_recording/12_ir_beacon_docking.png

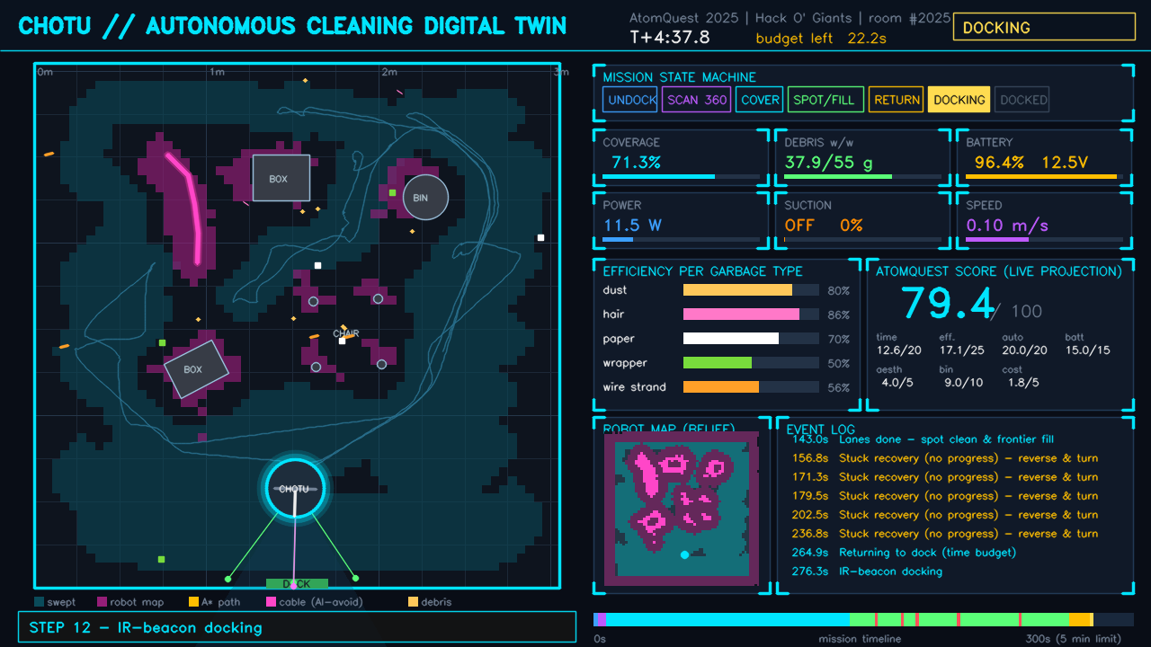
bot_simulation/simulation_screenshot_screen_recording/12_ir_beacon_docking.png
