Gurjas2112/CHOTU/bot_simulation/simulation_screenshot_screen_recording/13_mission_report.png

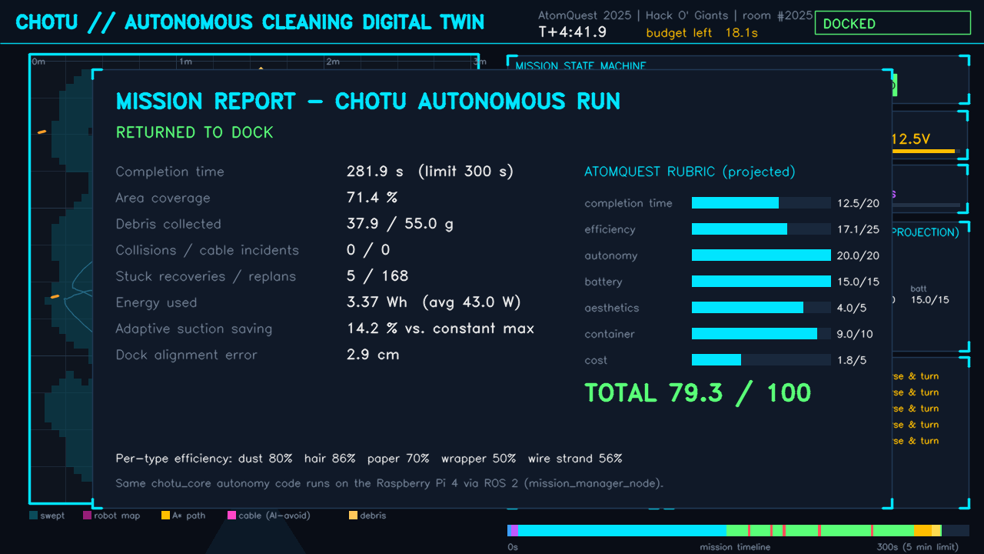
bot_simulation/simulation_screenshot_screen_recording/13_mission_report.png
