Gurjas2112/CHOTU/bot_simulation/simulation_screenshot_screen_recording/fleet_dashboard_4_robots.png

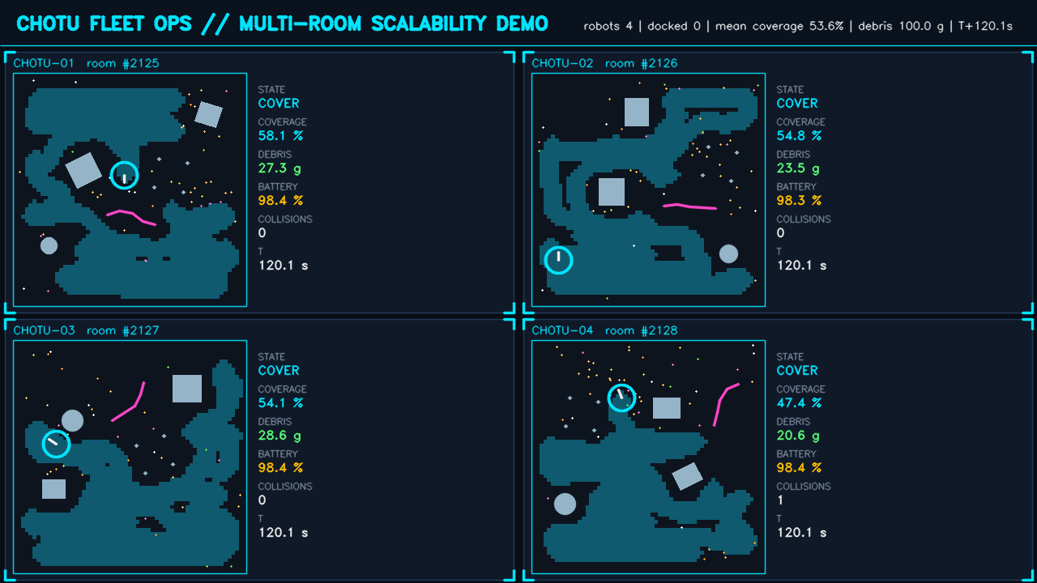
bot_simulation/simulation_screenshot_screen_recording/fleet_dashboard_4_robots.png
