Gurjas2112/CHOTU/essential_docs/AtomQuest2025_HackOGiants_PESMCOE_Images/bergmann_tornado_vacuum_motor.jpg

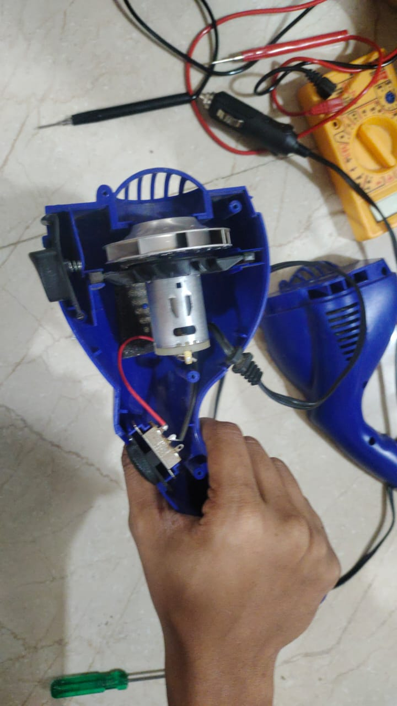
essential_docs/AtomQuest2025_HackOGiants_PESMCOE_Images/bergmann_tornado_vacuum_motor.jpg
