Gurjas2112/CHOTU/essential_docs/AtomQuest2025_HackOGiants_PESMCOE_Images/bot_pic2_labelled_one.jpg

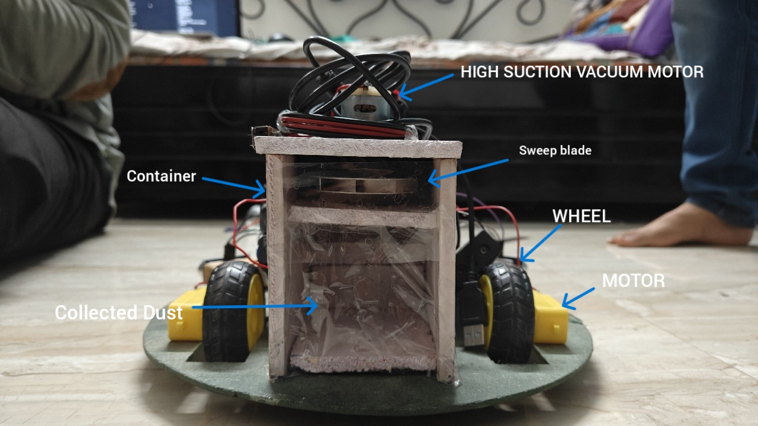
essential_docs/AtomQuest2025_HackOGiants_PESMCOE_Images/bot_pic2_labelled_one.jpg
