Gurjas2112/CHOTU/essential_docs/AtomQuest2025_HackOGiants_PESMCOE_Images/caster_wheel_ball.jpg

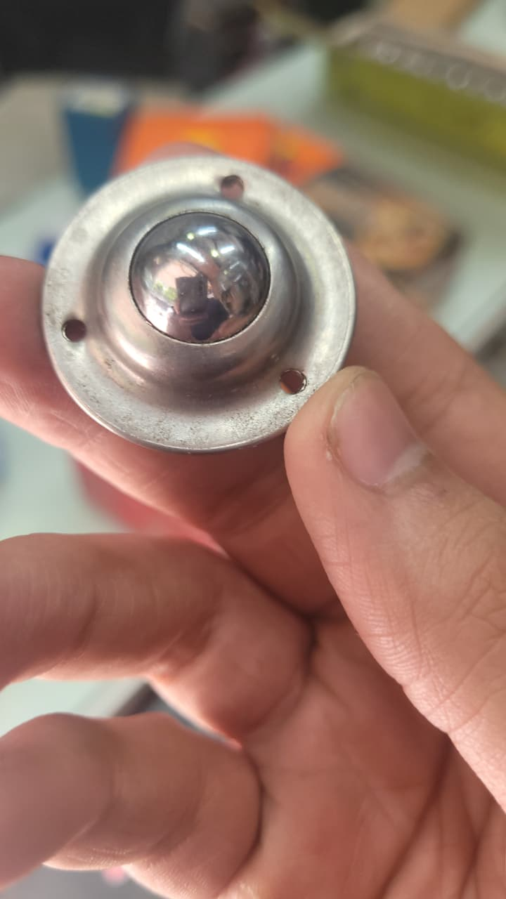
essential_docs/AtomQuest2025_HackOGiants_PESMCOE_Images/caster_wheel_ball.jpg
