Gurjas2112/CHOTU/essential_docs/AtomQuest2025_HackOGiants_PESMCOE_Images/dtof_lidar_sensor.jpg

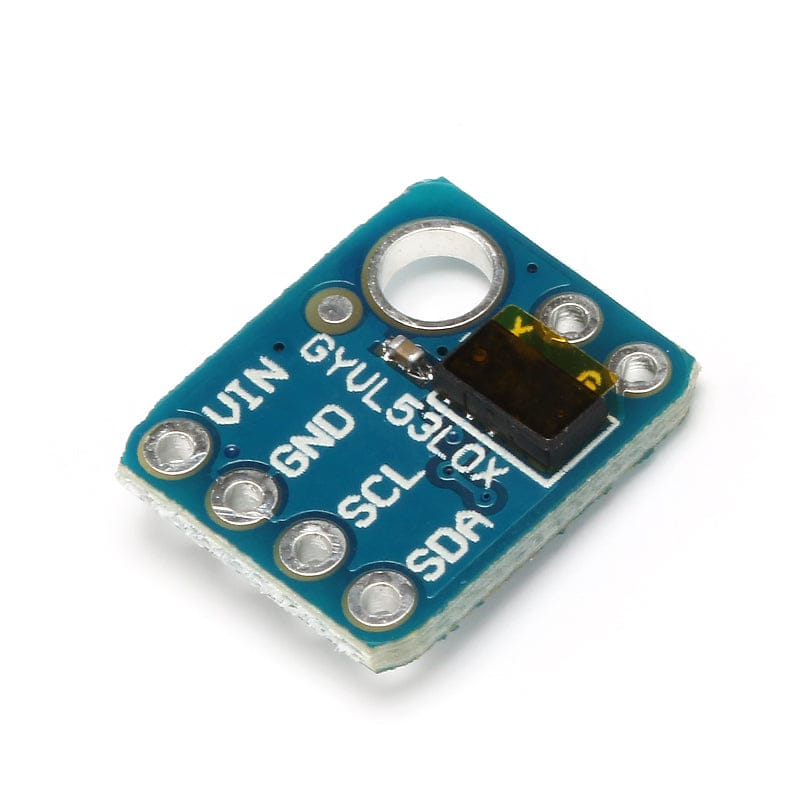
essential_docs/AtomQuest2025_HackOGiants_PESMCOE_Images/dtof_lidar_sensor.jpg
