Gurjas2112/CHOTU/essential_docs/AtomQuest2025_HackOGiants_PESMCOE_Images/ESP32_Cam_AI_Vision_Module.jpeg

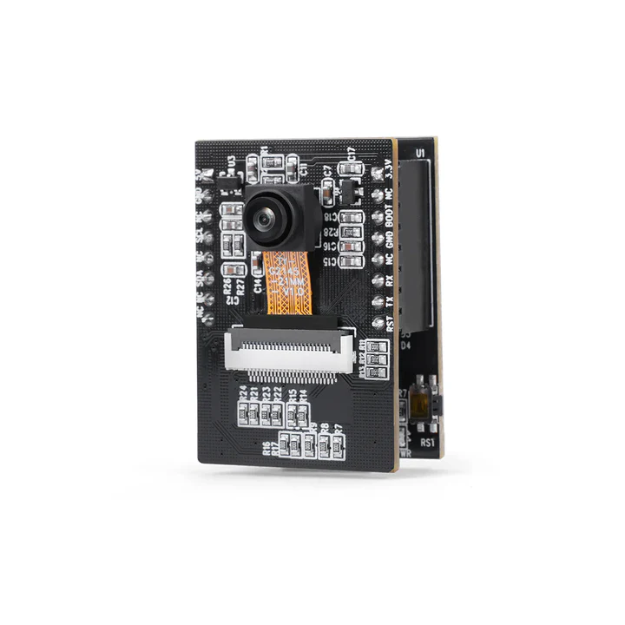
essential_docs/AtomQuest2025_HackOGiants_PESMCOE_Images/ESP32_Cam_AI_Vision_Module.jpeg
