Gurjas2112/CHOTU/essential_docs/AtomQuest2025_HackOGiants_PESMCOE_Images/team_photo.jpg

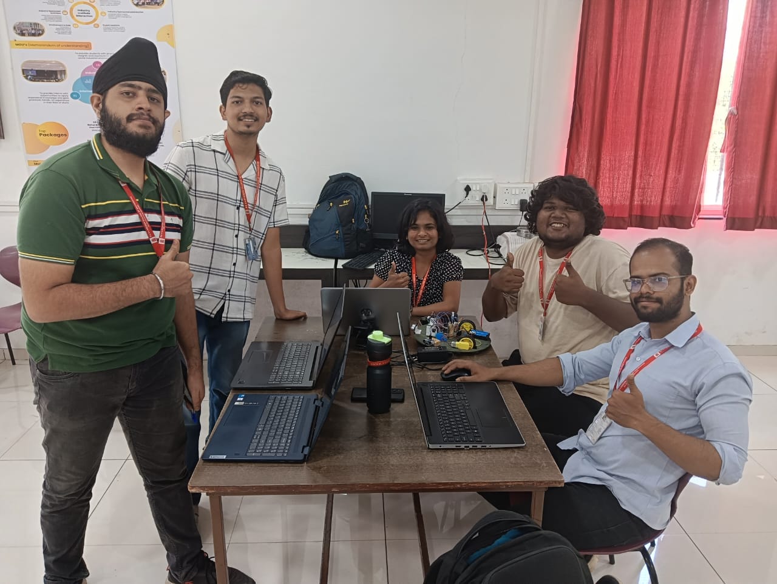
essential_docs/AtomQuest2025_HackOGiants_PESMCOE_Images/team_photo.jpg
