Gurjas2112/CHOTU/essential_docs/AtomQuest2025_HackOGiants_PESMCOE_Images/ultrasonic_sensor.png

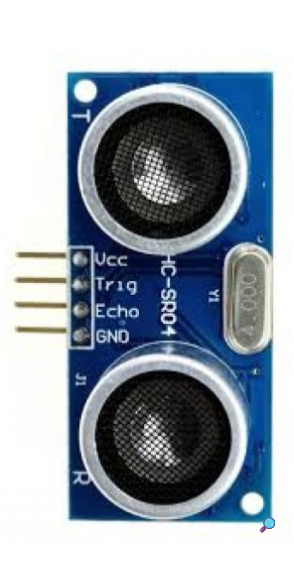
essential_docs/AtomQuest2025_HackOGiants_PESMCOE_Images/ultrasonic_sensor.png
