Gurjas2112/CHOTU/essential_docs/AtomQuest2025_HackOGiants_PESMCOE_Images/Vibration sensor module alarm Motion sensor module vibration switch SW-420.png

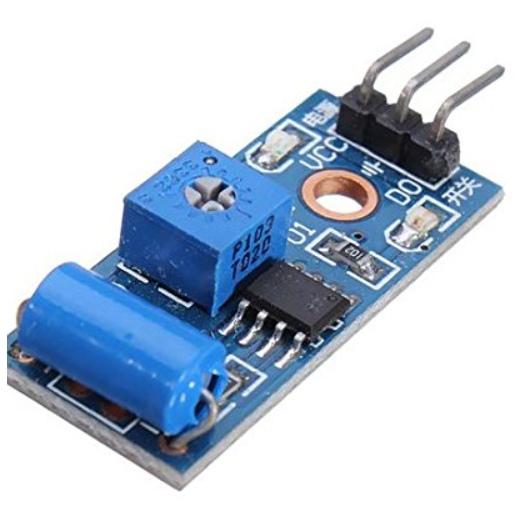
essential_docs/AtomQuest2025_HackOGiants_PESMCOE_Images/Vibration sensor module alarm Motion sensor module vibration switch SW-420.png
