Gurjas2112/CHOTU/essential_docs/bot_connection_schema.jpeg

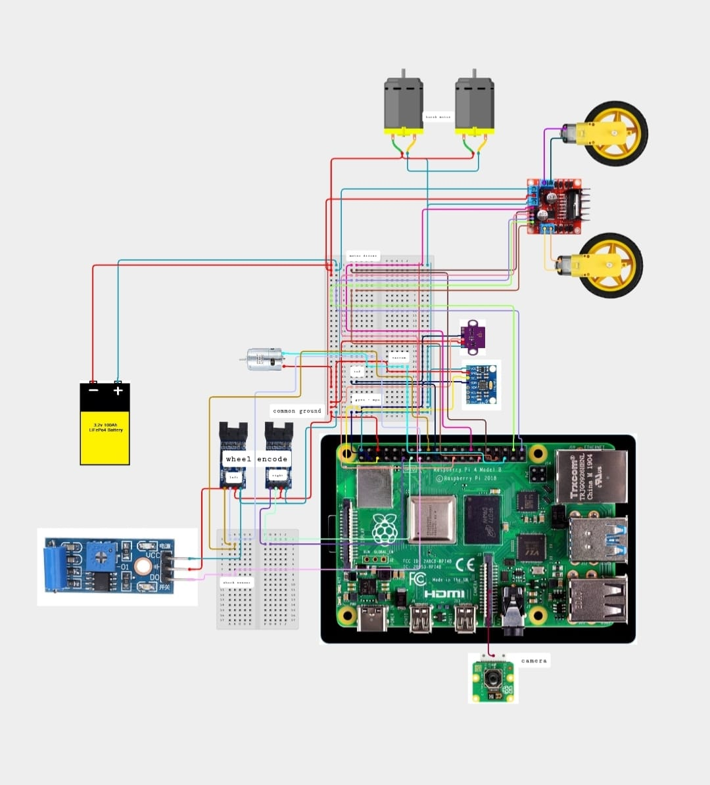
essential_docs/bot_connection_schema.jpeg
