Gurjas2112/CHOTU/essential_docs/cleaning_bot_cad_design/bot_cad_design_pic2.jpg

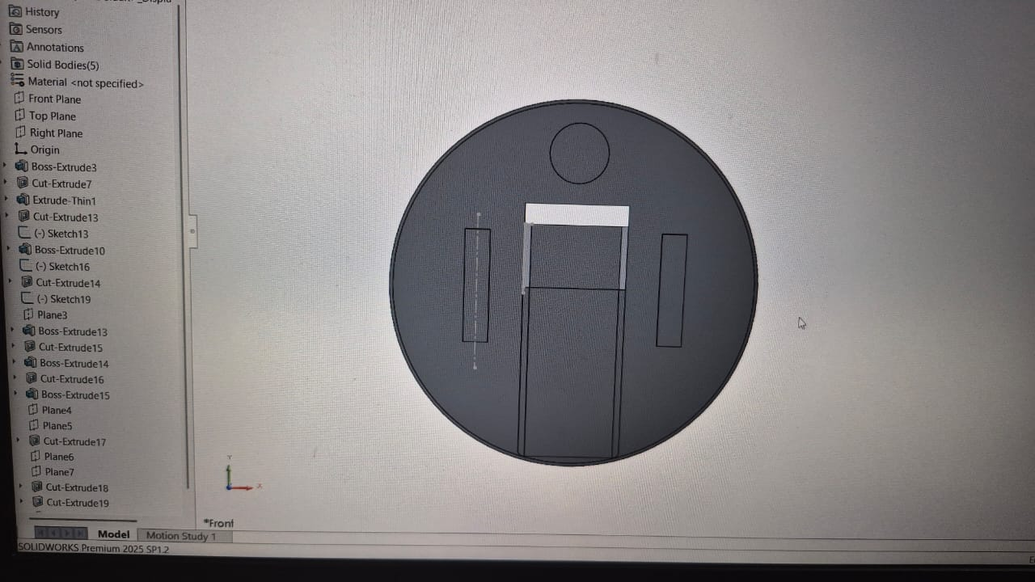
essential_docs/cleaning_bot_cad_design/bot_cad_design_pic2.jpg
