Gurjas2112/CHOTU/hardware/pcb/schematic/01_mcu_pinmap.png

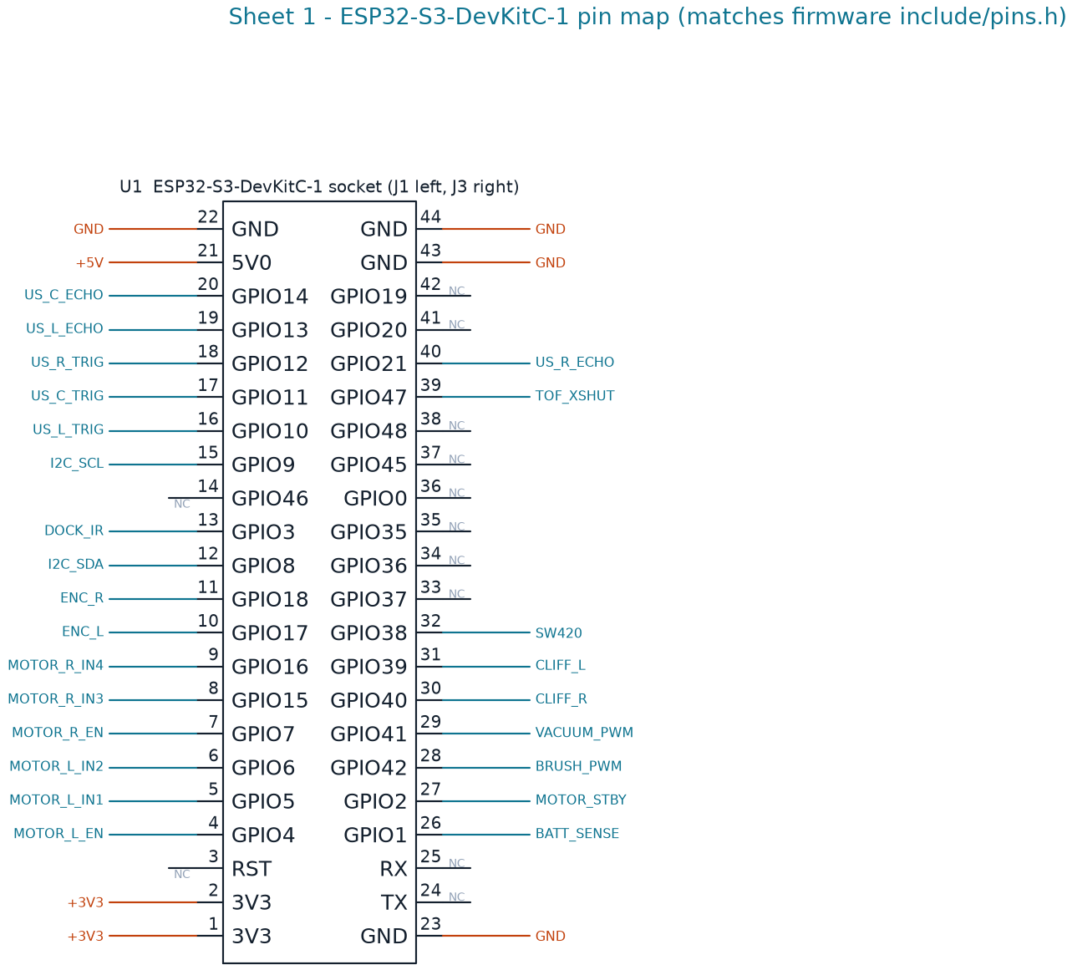
hardware/pcb/schematic/01_mcu_pinmap.png
