Gurjas2112/CHOTU/hardware/pcb/schematic/02_power.png

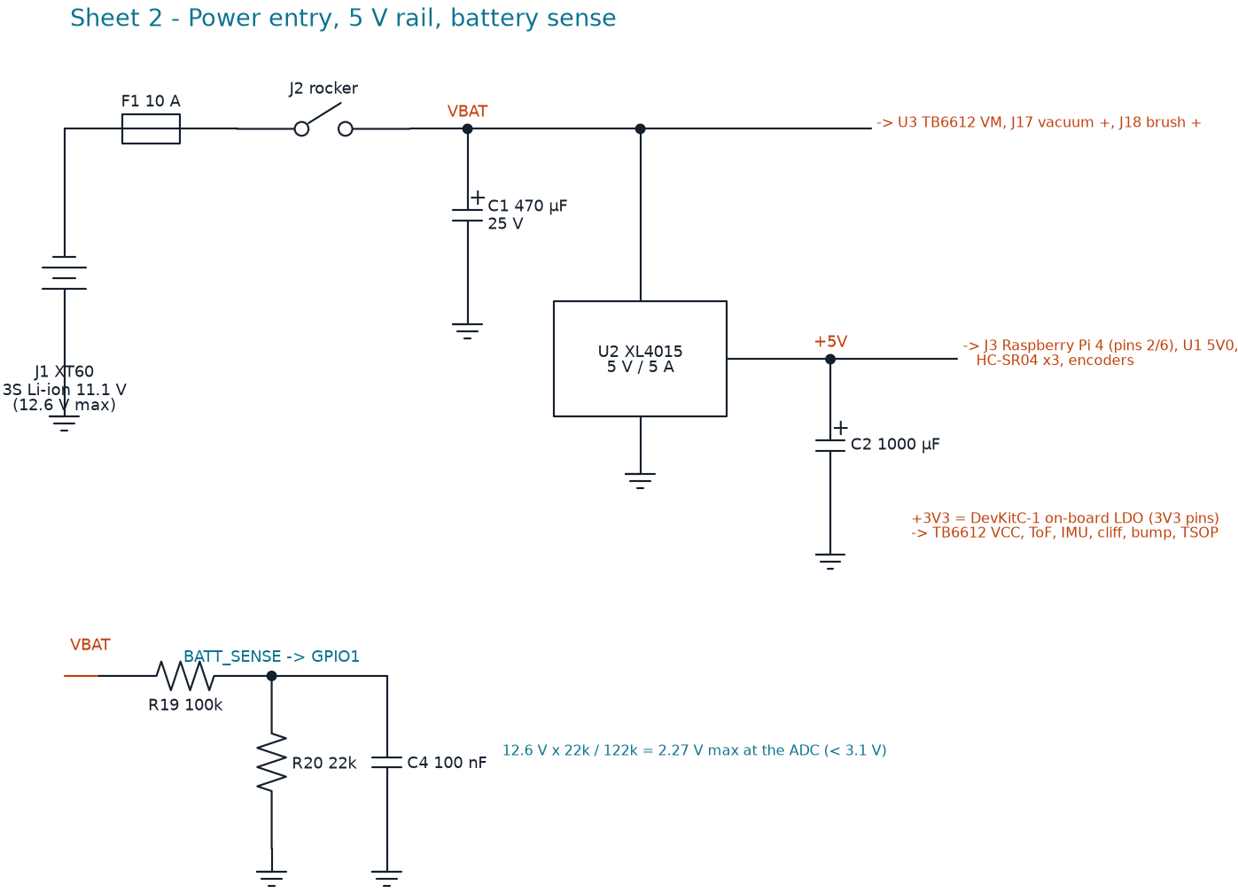
hardware/pcb/schematic/02_power.png
