Gurjas2112/CHOTU/hardware/pcb/schematic/03_motor_drive.png

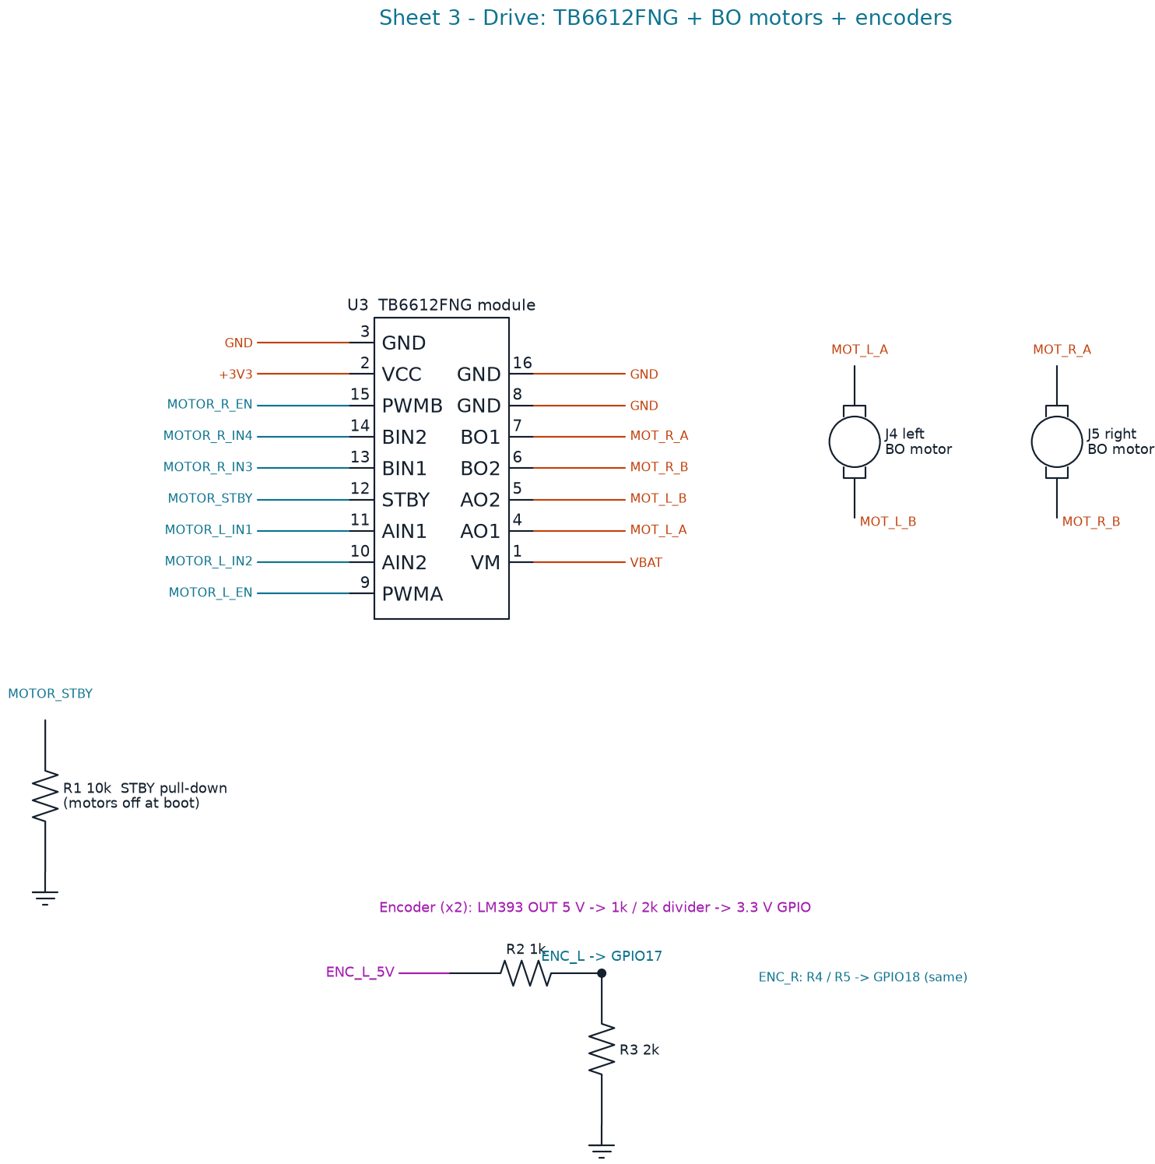
hardware/pcb/schematic/03_motor_drive.png
