Gurjas2112/CHOTU/hardware/pcb/schematic/04_vacuum_brush_drivers.png

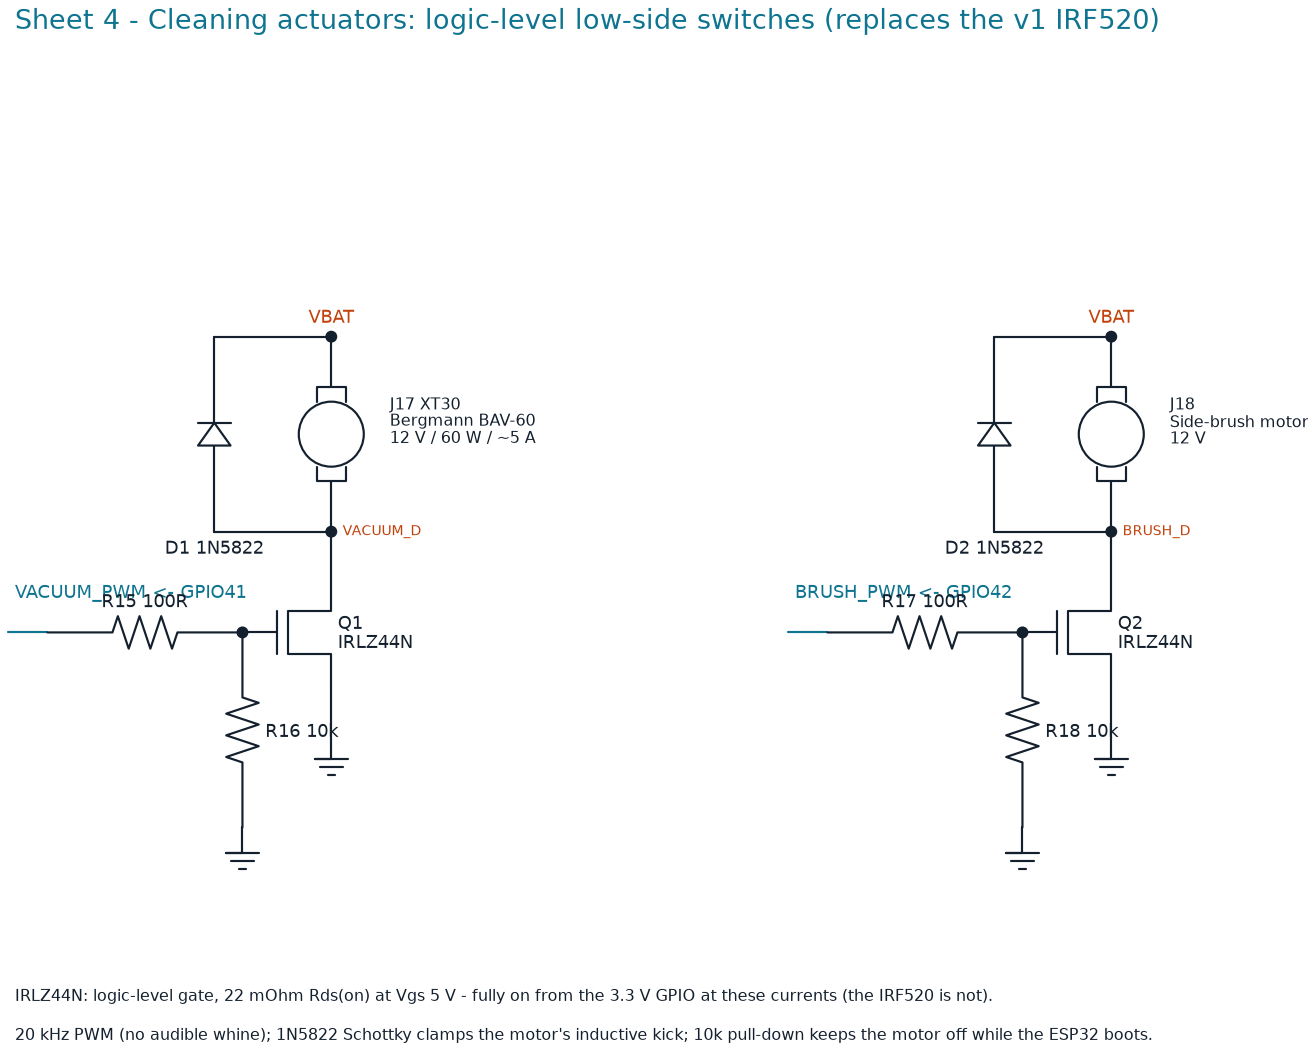
hardware/pcb/schematic/04_vacuum_brush_drivers.png
