Gurjas2112/CHOTU/hardware/pcb/schematic/05_sensors.png

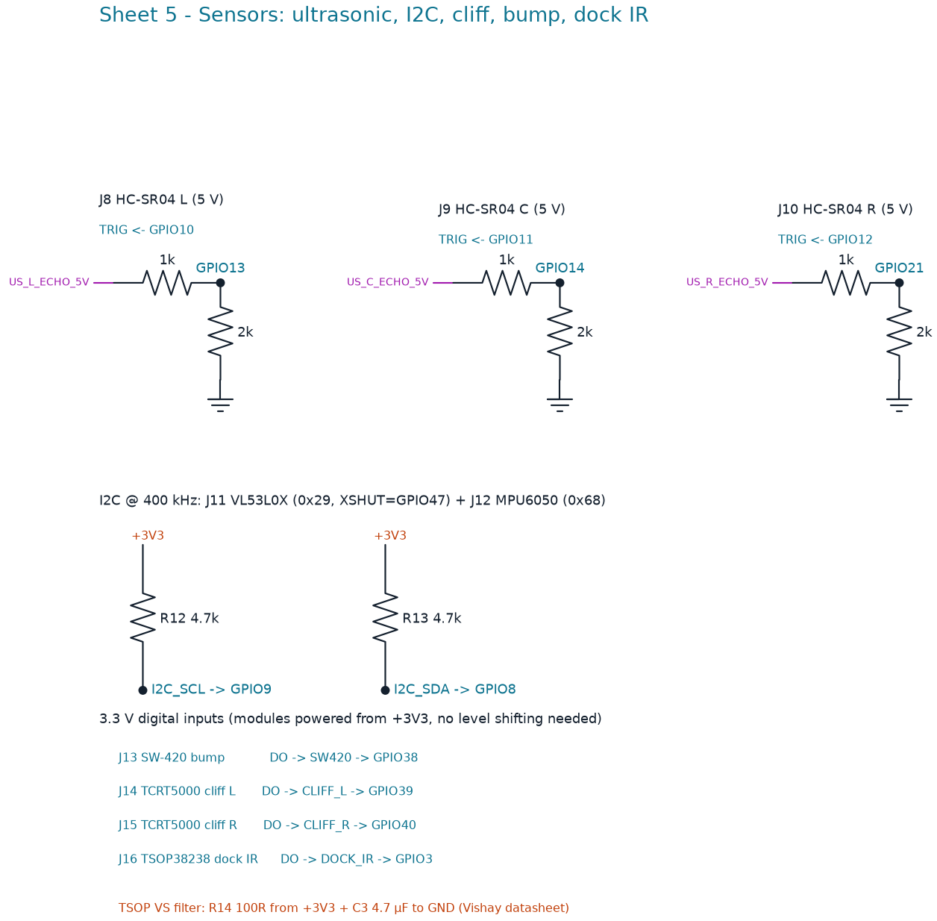
hardware/pcb/schematic/05_sensors.png
