Gurjas2112/CHOTU/mobile_app/app_screenshot_screen_recording/01_connect_screen.png

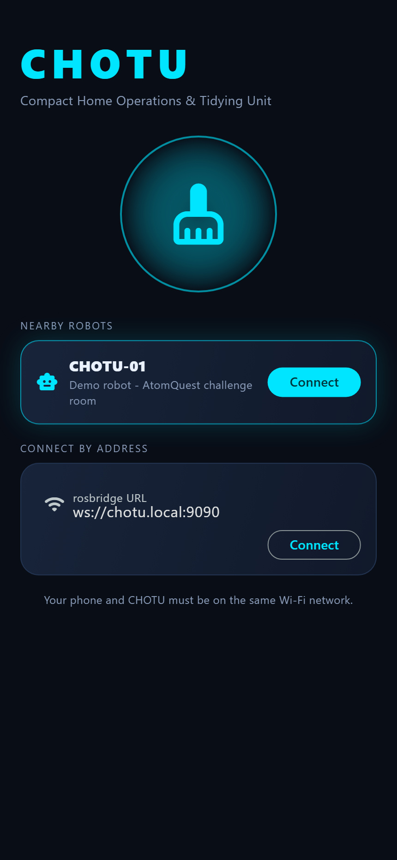
mobile_app/app_screenshot_screen_recording/01_connect_screen.png
