Gurjas2112/CHOTU/mobile_app/app_screenshot_screen_recording/06_no_go_edit_mode.png

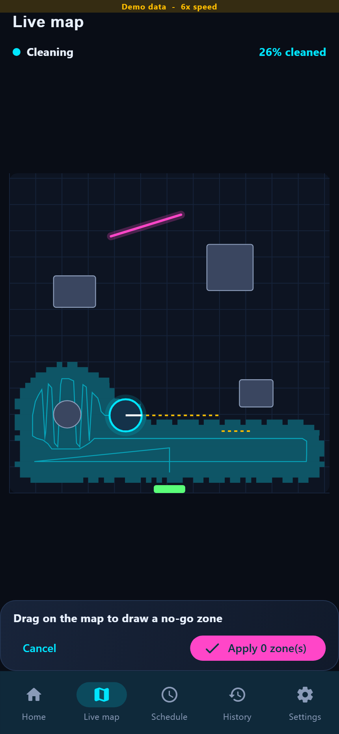
mobile_app/app_screenshot_screen_recording/06_no_go_edit_mode.png
