Gurjas2112/CHOTU/mobile_app/app_screenshot_screen_recording/10_alerts_list.png

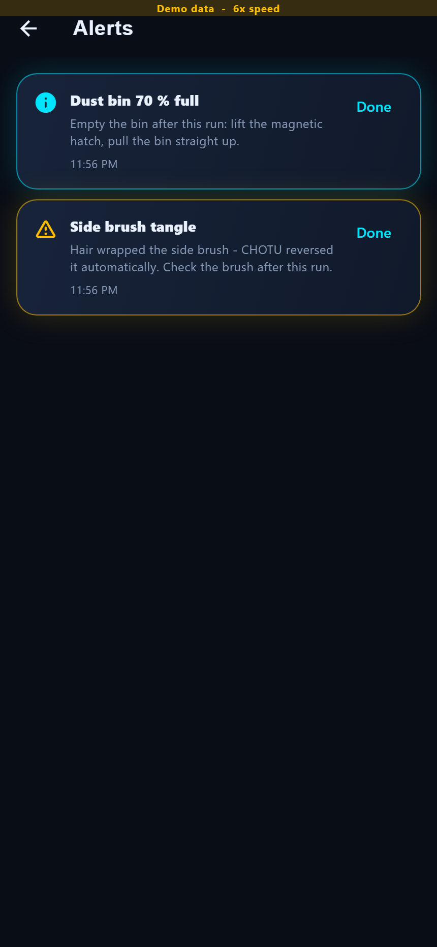
mobile_app/app_screenshot_screen_recording/10_alerts_list.png
