Gurjas2112/CHOTU/mobile_app/app_screenshot_screen_recording/11_schedules.png

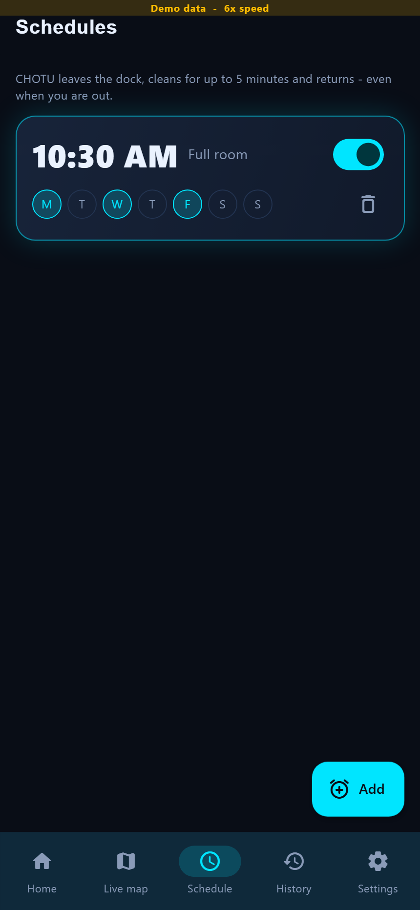
mobile_app/app_screenshot_screen_recording/11_schedules.png
