Gurjas2112/CHOTU/mobile_app/app_screenshot_screen_recording/13_return_to_dock.png

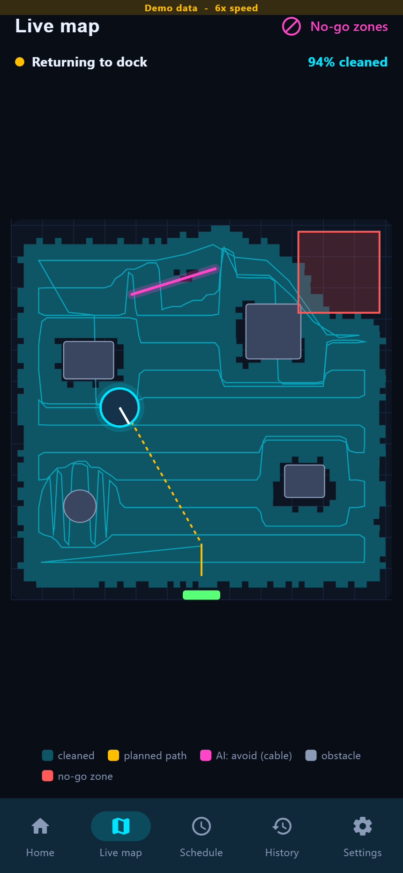
mobile_app/app_screenshot_screen_recording/13_return_to_dock.png
