Gurjas2112/CHOTU/hardware/pcb/protoflow/bom_jlcpcb.csv

Comment | Designator | Footprint | LCSC (suggested, JLC basic)
XT60 battery 3S 11.1V | J1 | Connector_AMASS:AMASS_XT60-M_1x02_P7.20mm_Vertical | hand-solder / module
Fuse 10A ATO | F1 | Fuse:Fuseholder_Blade_ATO_Littelfuse_FLR_178.6165 | hand-solder / module
Rocker switch (panel) | J2 | Connector_JST:JST_XH_B2B-XH-A_1x02_P2.50mm_Vertical | hand-solder / module
470uF 25V | C1 | Capacitor_THT:CP_Radial_D10.0mm_P5.00mm | hand-solder / module
XL4015 5V/5A buck module | U2 | CHOTU:XL4015_module_pads | hand-solder / module
1000uF 10V | C2 | Capacitor_THT:CP_Radial_D10.0mm_P5.00mm | hand-solder / module
Raspberry Pi 4 5V feed (GPIO pins 2/6) | J3 | Connector_JST:JST_XH_B2B-XH-A_1x02_P2.50mm_Vertical | hand-solder / module
ESP32-S3-DevKitC-1 (N8R8) | U1 | CHOTU:ESP32-S3-DevKitC-1_2x22_socket | hand-solder / module
TB6612FNG module | U3 | CHOTU:TB6612FNG_module_2x8 | hand-solder / module
10k | R1,R16,R18 | Resistor_SMD:R_0805_2012Metric | C17414
Left BO motor | J4 | Connector_JST:JST_XH_B2B-XH-A_1x02_P2.50mm_Vertical | hand-solder / module
Right BO motor | J5 | Connector_JST:JST_XH_B2B-XH-A_1x02_P2.50mm_Vertical | hand-solder / module
Encoder L (LM393) | J6 | Connector_JST:JST_XH_B3B-XH-A_1x03_P2.50mm_Vertical | hand-solder / module
1k | R2,R4,R6,R8,R10 | Resistor_SMD:R_0805_2012Metric | C17513
2k | R3,R5,R7,R9,R11 | Resistor_SMD:R_0805_2012Metric | C17604
Encoder R (LM393) | J7 | Connector_JST:JST_XH_B3B-XH-A_1x03_P2.50mm_Vertical | hand-solder / module
HC-SR04 L | J8 | Connector_JST:JST_XH_B4B-XH-A_1x04_P2.50mm_Vertical | hand-solder / module
HC-SR04 C | J9 | Connector_JST:JST_XH_B4B-XH-A_1x04_P2.50mm_Vertical | hand-solder / module
HC-SR04 R | J10 | Connector_JST:JST_XH_B4B-XH-A_1x04_P2.50mm_Vertical | hand-solder / module
VL53L0X ToF | J11 | Connector_JST:JST_XH_B5B-XH-A_1x05_P2.50mm_Vertical | hand-solder / module
MPU6050 IMU | J12 | Connector_JST:JST_XH_B4B-XH-A_1x04_P2.50mm_Vertical | hand-solder / module
4.7k | R12,R13 | Resistor_SMD:R_0805_2012Metric | C17673
SW-420 bump | J13 | Connector_JST:JST_XH_B3B-XH-A_1x03_P2.50mm_Vertical | hand-solder / module
TCRT5000 cliff L | J14 | Connector_JST:JST_XH_B3B-XH-A_1x03_P2.50mm_Vertical | hand-solder / module
TCRT5000 cliff R | J15 | Connector_JST:JST_XH_B3B-XH-A_1x03_P2.50mm_Vertical | hand-solder / module
TSOP38238 dock IR | J16 | Connector_JST:JST_XH_B3B-XH-A_1x03_P2.50mm_Vertical | hand-solder / module
100R | R14,R15,R17 | Resistor_SMD:R_0805_2012Metric | C17408
4.7uF | C3 | Capacitor_SMD:C_0805_2012Metric | C1779
IRLZ44N | Q1,Q2 | Package_TO_SOT_THT:TO-220-3_Vertical | hand-solder / module
1N5822 | D1,D2 | Diode_THT:D_DO-201AD_P15.24mm_Horizontal | hand-solder / module
Bergmann BAV-60 vacuum 12V/60W | J17 | Connector_AMASS:AMASS_XT30PW-M_1x02_P2.50mm_Horizontal | hand-solder / module
Side-brush motor 12V | J18 | Connector_JST:JST_XH_B2B-XH-A_1x02_P2.50mm_Vertical | hand-solder / module
100k | R19 | Resistor_SMD:R_0805_2012Metric | C17407
22k | R20 | Resistor_SMD:R_0805_2012Metric | C17560
100nF | C4 | Capacitor_SMD:C_0805_2012Metric | C49678
TP VBAT | TP1 | TestPoint:TestPoint_Pad_D2.0mm | hand-solder / module
TP +5V | TP2 | TestPoint:TestPoint_Pad_D2.0mm | hand-solder / module
TP +3V3 | TP3 | TestPoint:TestPoint_Pad_D2.0mm | hand-solder / module
TP GND | TP4 | TestPoint:TestPoint_Pad_D2.0mm | hand-solder / module
