Gurjas2112/CHOTU/essential_docs/AtomQuest2025_HackOGiants_PESMCOE_Essential_component_bills/Bill-2.pdf

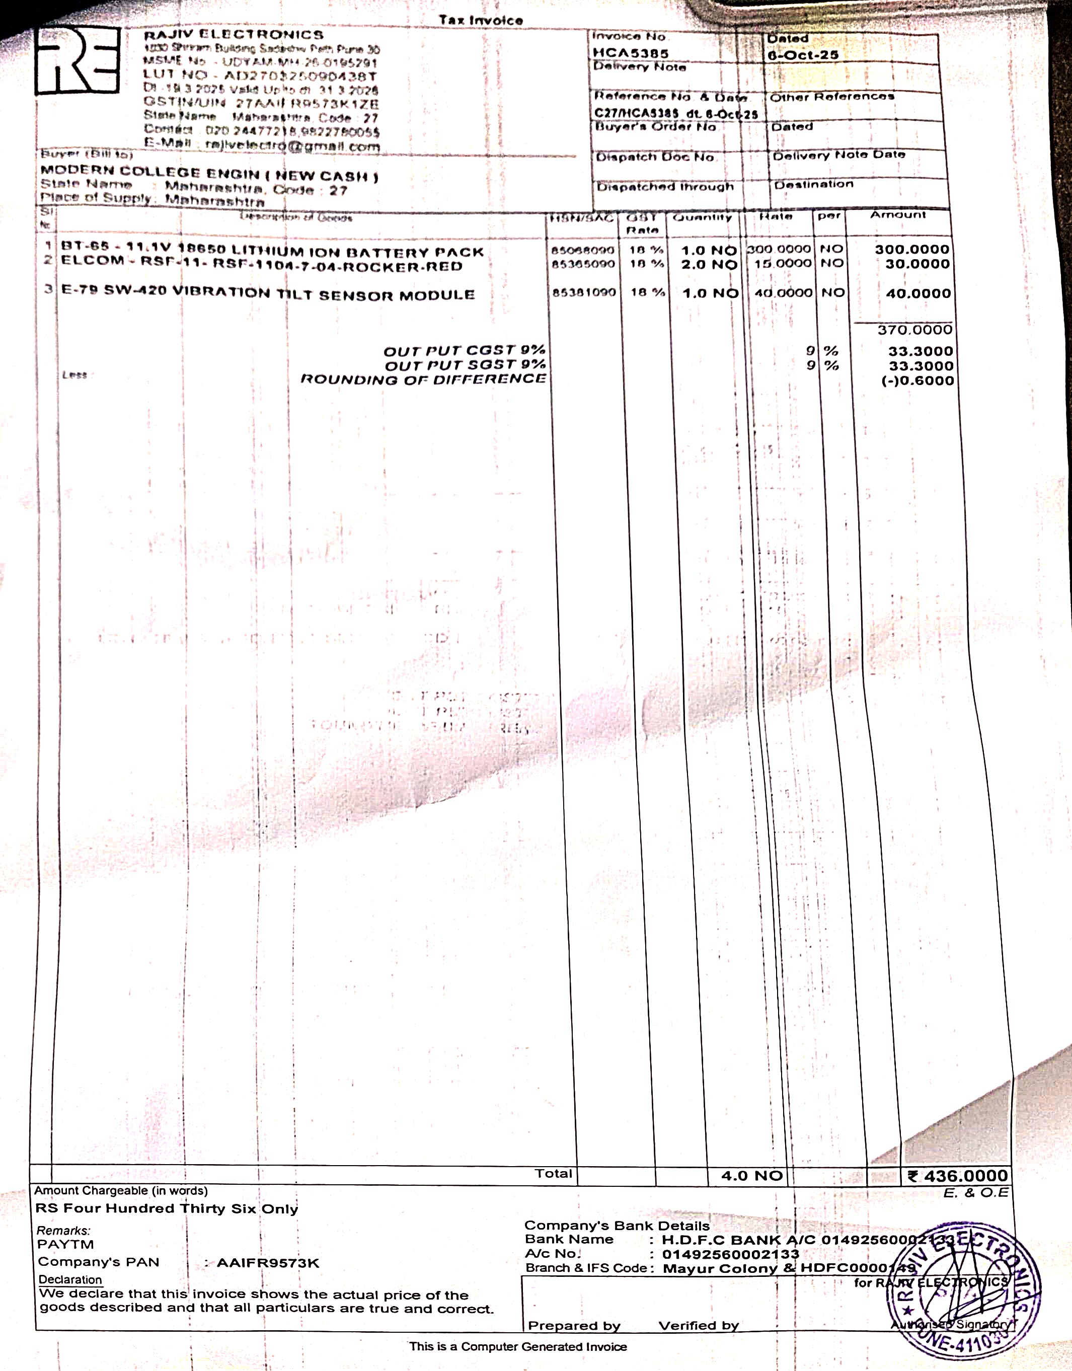
[picture p61: page 1]
