Gurjas2112/CHOTU/old_essential_docs/AtomQuest2025_HackOGiants_PESMCOE_Essential_component_bills/Bill-3.pdf

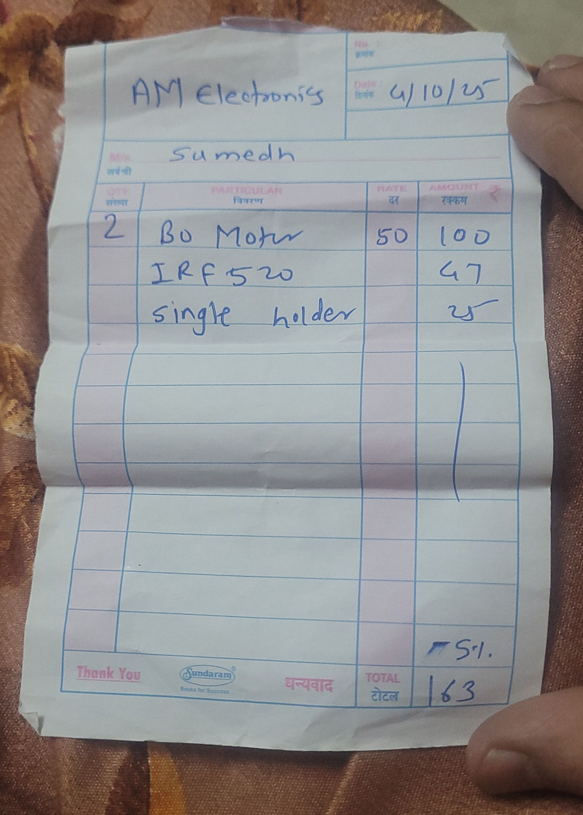
[picture p62: page 1]
