Gurjas2112/CHOTU/essential_docs/AtomQuest2025_HackOGiants_PESMCOE_Essential_component_bills/motor_prize_label.jpeg

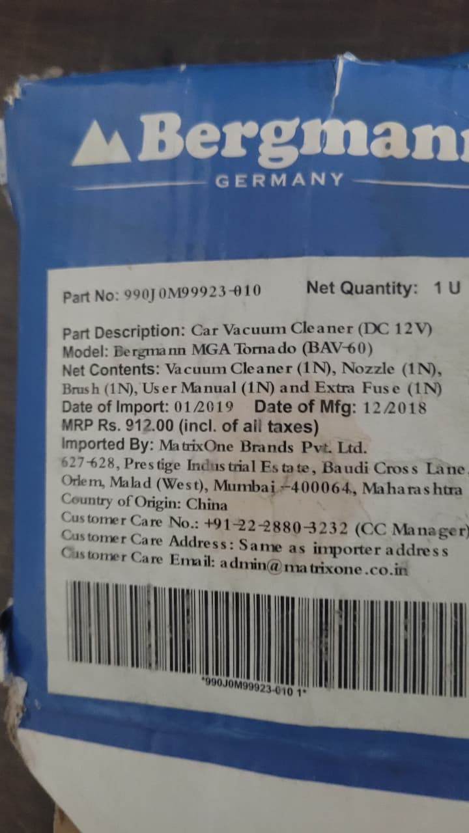
essential_docs/AtomQuest2025_HackOGiants_PESMCOE_Essential_component_bills/motor_prize_label.jpeg
