Gurjas2112/CHOTU/essential_docs/AtomQuest2025_HackOGiants_PESMCOE_Images/reference_3d_printed_parts_bot_chassis.jpeg

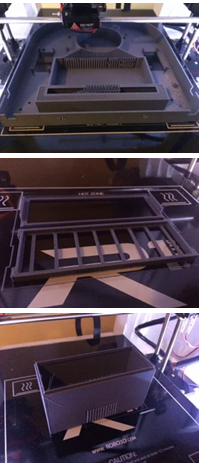
essential_docs/AtomQuest2025_HackOGiants_PESMCOE_Images/reference_3d_printed_parts_bot_chassis.jpeg
