Gurjas2112/CHOTU/bot_3d_printing/step/chotu_v3_assembly.step

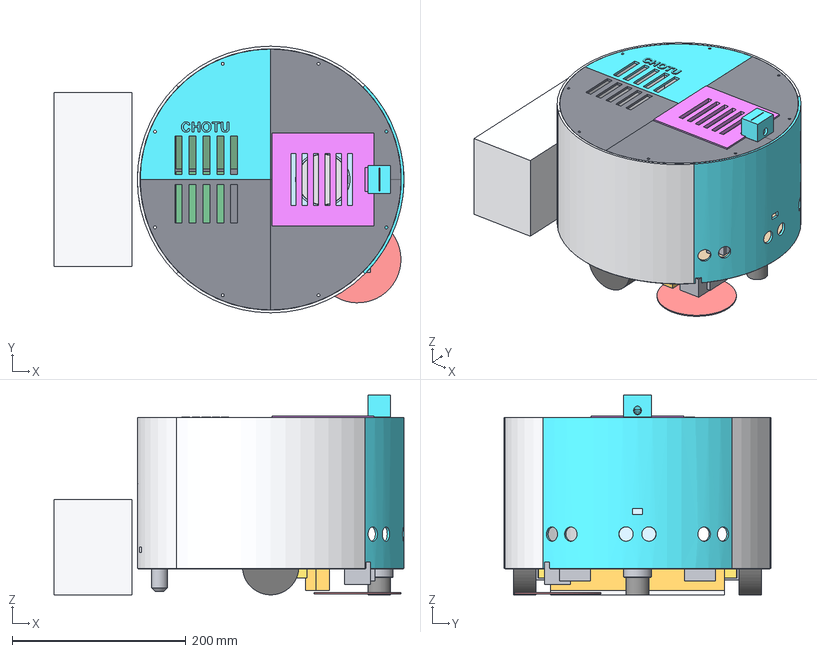
[picture p65: CAD file, 2026-10-17]
bot_3d_printing/step/chotu_v3_assembly.step
403.0 x 307.0 x 230.0 mm
mdf_base
bumper_front
bumper_left
bumper_rear
bumper_right
lid_tile_1
lid_tile_2
lid_tile_3
lid_tile_4
suction_nozzle
dust_bin
bin_filter_lid
bin_cradle
motor_bracket_left
motor_bracket_right
caster_spacer
side_brush_mount
cliff_mount_left
cliff_mount_right
battery_tray
camera_pod
deck_pillar_1
deck_pillar_2
deck_pillar_3
deck_pillar_4
electronics_deck
ref_wheel_1
ref_bo_motor_1
ref_wheel_-1
ref_bo_motor_-1
ref_bergmann_motor
ref_battery_bt65
ref_raspberry_pi4
ref_carrier_pcb
ref_caster
ref_side_brush
bin_hatch
rear_skid
dock_station
