Gurjas2112/CHOTU/bot_3d_printing/dxf/mdf_base_template.dxf

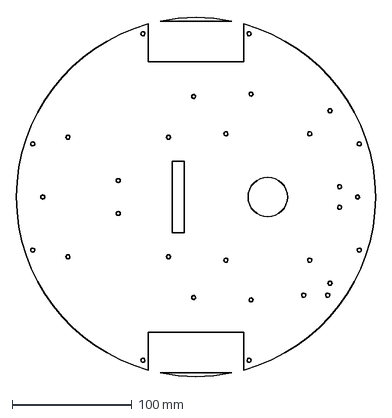
[picture p66: CAD file, 2026-10-17]
bot_3d_printing/dxf/mdf_base_template.dxf
300.0 x 302.0 mm
