Gurjas2112/CHOTU/bot_3d_printing/step/bumper_rear.step

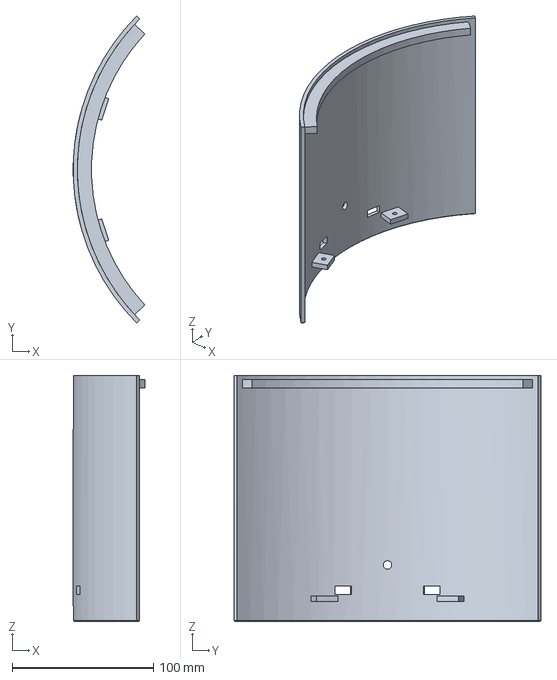
[picture p67: CAD file, 2026-10-17]
bot_3d_printing/step/bumper_rear.step
50.7 x 217.1 x 174.0 mm
