Gurjas2112/CHOTU/bot_3d_printing/step/battery_tray.step

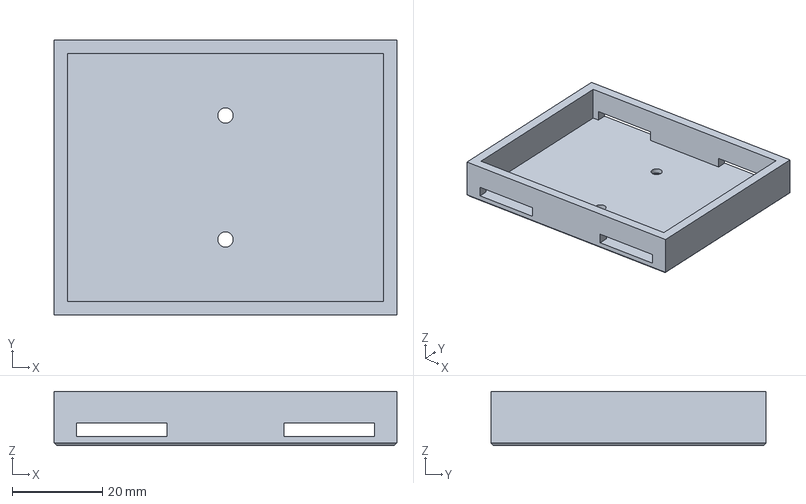
[picture p68: CAD file, 2026-10-17]
bot_3d_printing/step/battery_tray.step
76.0 x 61.0 x 12.0 mm
