Gurjas2112/CHOTU/bot_3d_printing/step/camera_pod.step

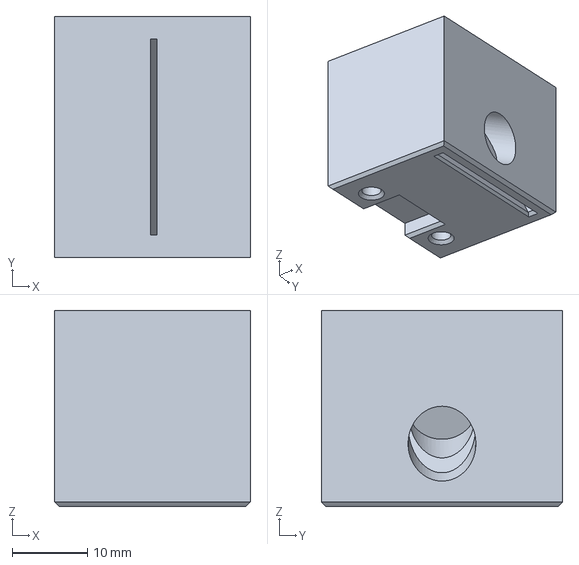
[picture p69: CAD file, 2026-10-17]
bot_3d_printing/step/camera_pod.step
26.0 x 32.0 x 26.0 mm
