Gurjas2112/CHOTU/bot_3d_printing/step/side_brush_mount.step

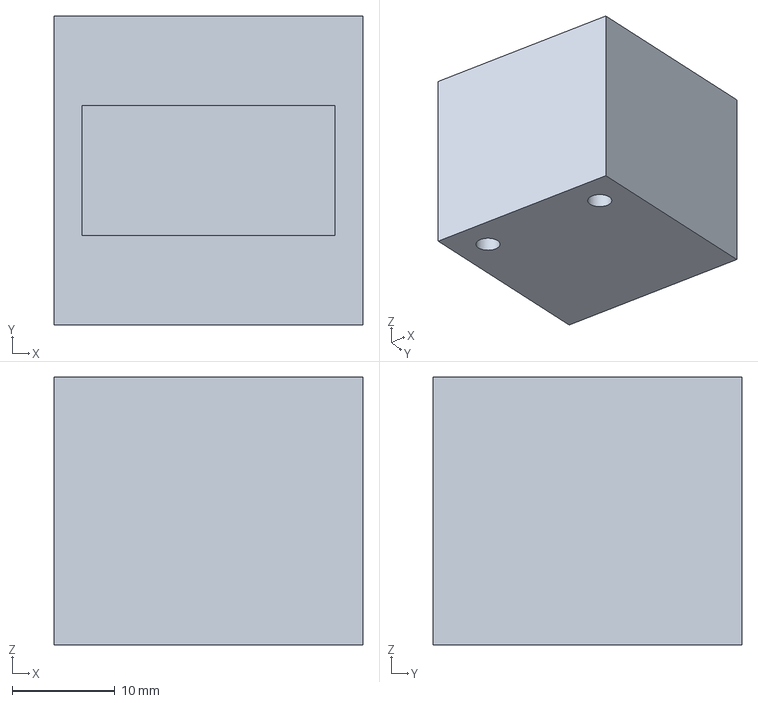
[picture p70: CAD file, 2026-10-17]
bot_3d_printing/step/side_brush_mount.step
30.0 x 30.0 x 26.0 mm
