Gurjas2112/CHOTU/bot_3d_printing/step/deck_pillar_4.step

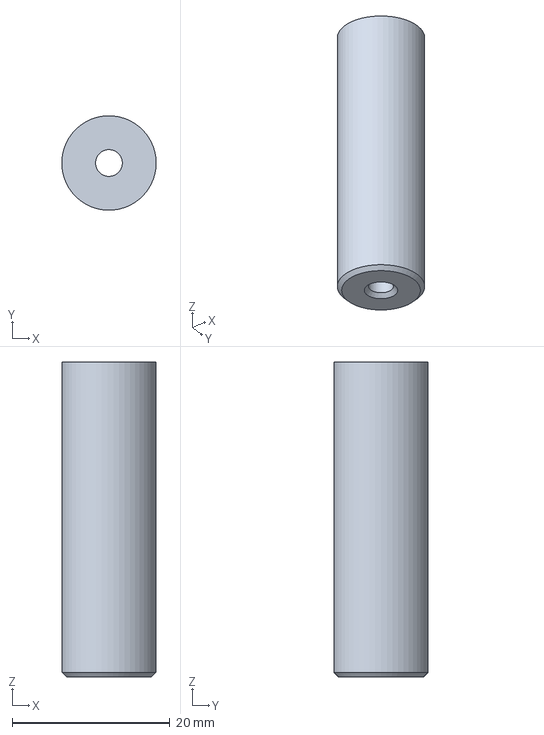
[picture p71: CAD file, 2026-10-17]
bot_3d_printing/step/deck_pillar_4.step
12.0 x 12.0 x 40.0 mm
