Gurjas2112/CHOTU/bot_3d_printing/step/bin_cradle.step

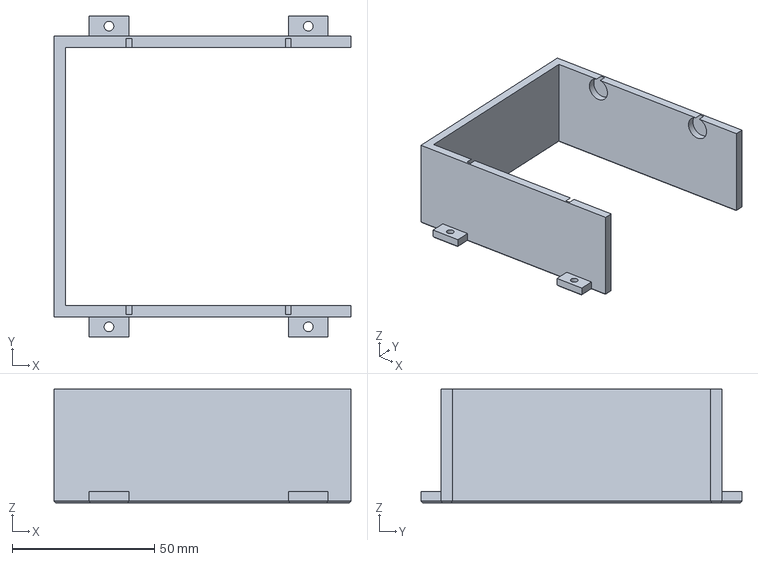
[picture p72: CAD file, 2026-10-17]
bot_3d_printing/step/bin_cradle.step
104.3 x 112.6 x 40.0 mm
