Gurjas2112/CHOTU/bot_3d_printing/step/cliff_mount_left.step

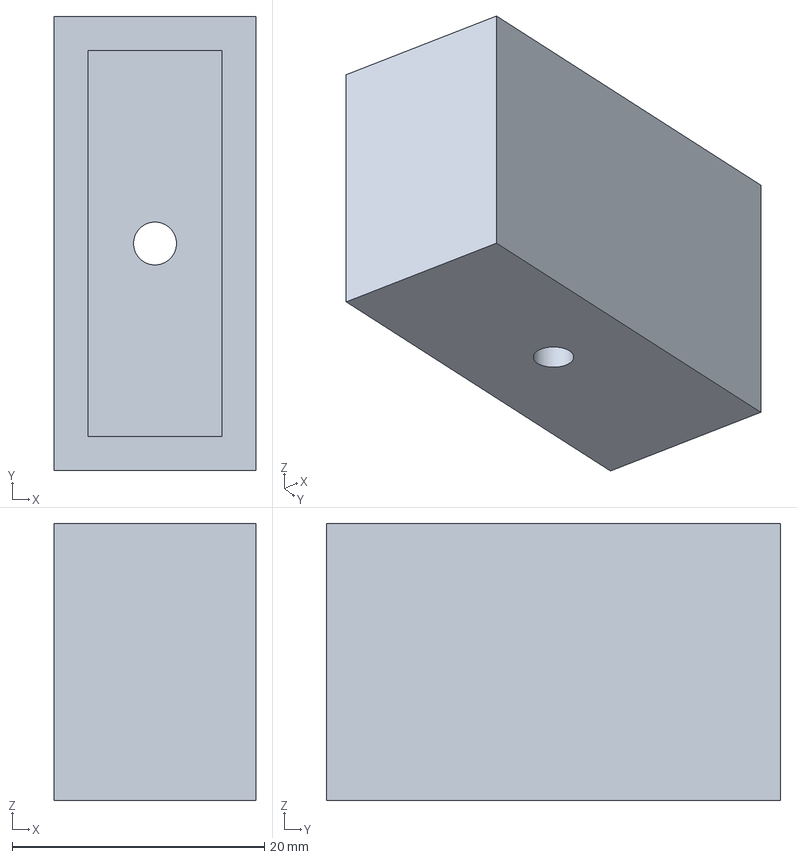
[picture p73: CAD file, 2026-10-17]
bot_3d_printing/step/cliff_mount_left.step
16.0 x 36.0 x 22.0 mm
