Gurjas2112/CHOTU/bot_3d_printing/step/lid_tile_4.step

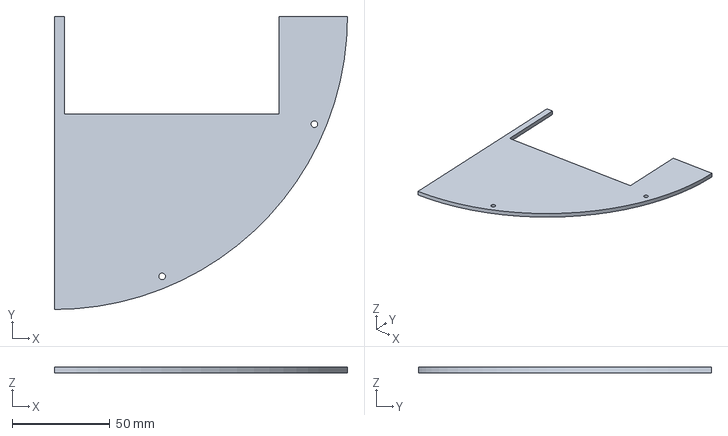
[picture p74: CAD file, 2026-10-17]
bot_3d_printing/step/lid_tile_4.step
150.2 x 150.2 x 3.00 mm
