Gurjas2112/CHOTU/bot_3d_printing/step/bin_hatch.step

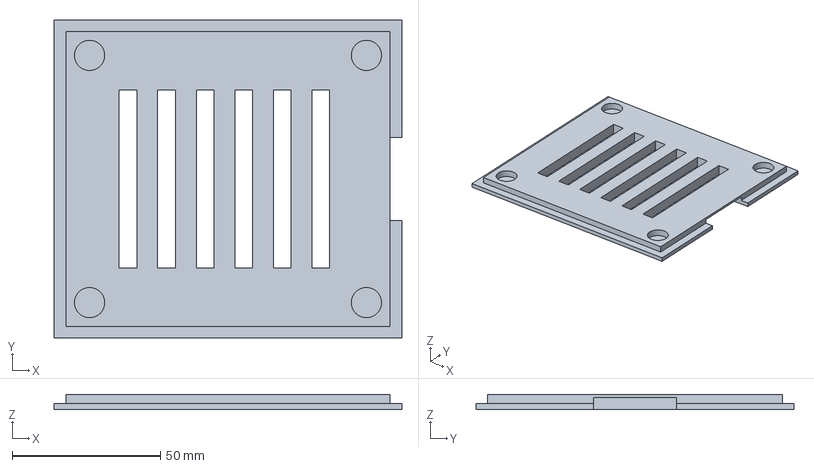
[picture p75: CAD file, 2026-10-17]
bot_3d_printing/step/bin_hatch.step
117.4 x 107.4 x 5.00 mm
