Gurjas2112/CHOTU/bot_3d_printing/step/dust_bin.step

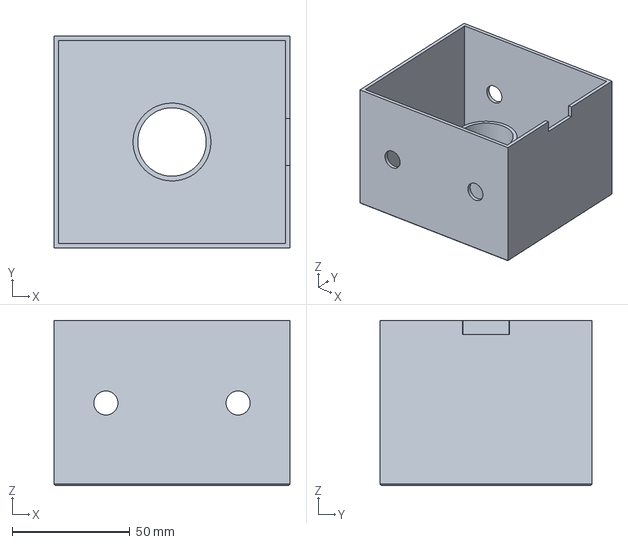
[picture p77: CAD file, 2026-10-17]
bot_3d_printing/step/dust_bin.step
100.0 x 90.0 x 70.0 mm
