Gurjas2112/CHOTU/bot_3d_printing/step/motor_bracket_left.step

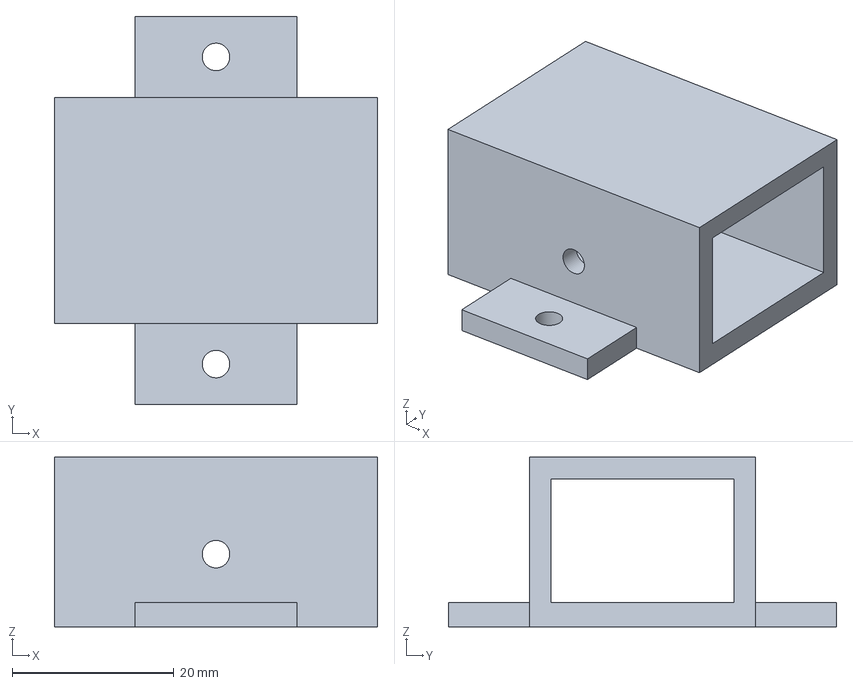
[picture p79: CAD file, 2026-10-17]
bot_3d_printing/step/motor_bracket_left.step
40.0 x 48.0 x 21.0 mm
