Gurjas2112/CHOTU/bot_3d_printing/step/lid_tile_2.step

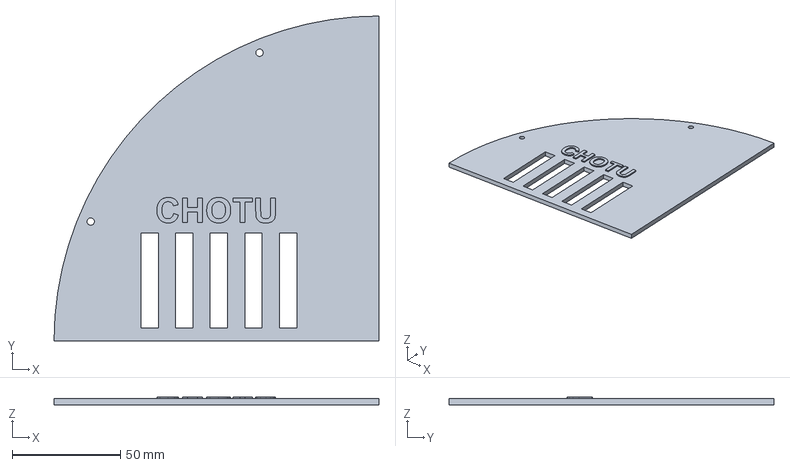
[picture p80: CAD file, 2026-10-17]
bot_3d_printing/step/lid_tile_2.step
150.2 x 150.2 x 3.80 mm
