Gurjas2112/CHOTU/bot_3d_printing/step/bin_filter_lid.step

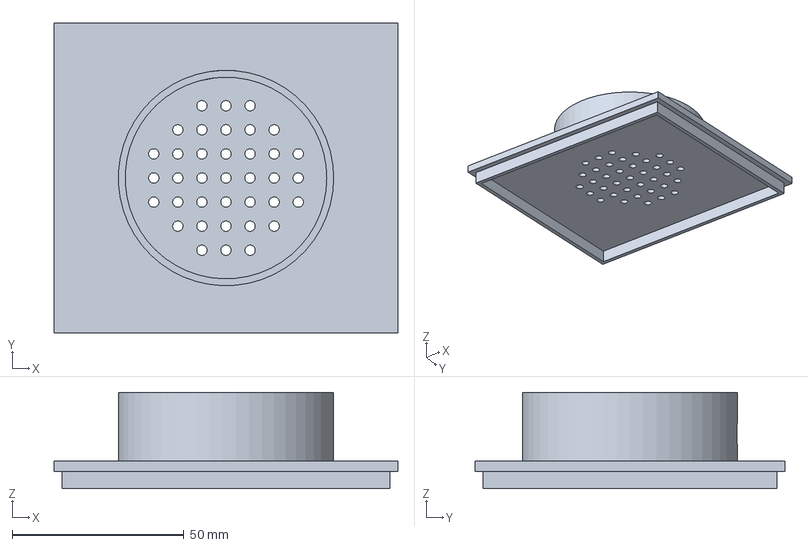
[picture p81: CAD file, 2026-10-17]
bot_3d_printing/step/bin_filter_lid.step
100.0 x 90.0 x 28.0 mm
