Gurjas2112/CHOTU/bot_3d_printing/step/dock_station.step

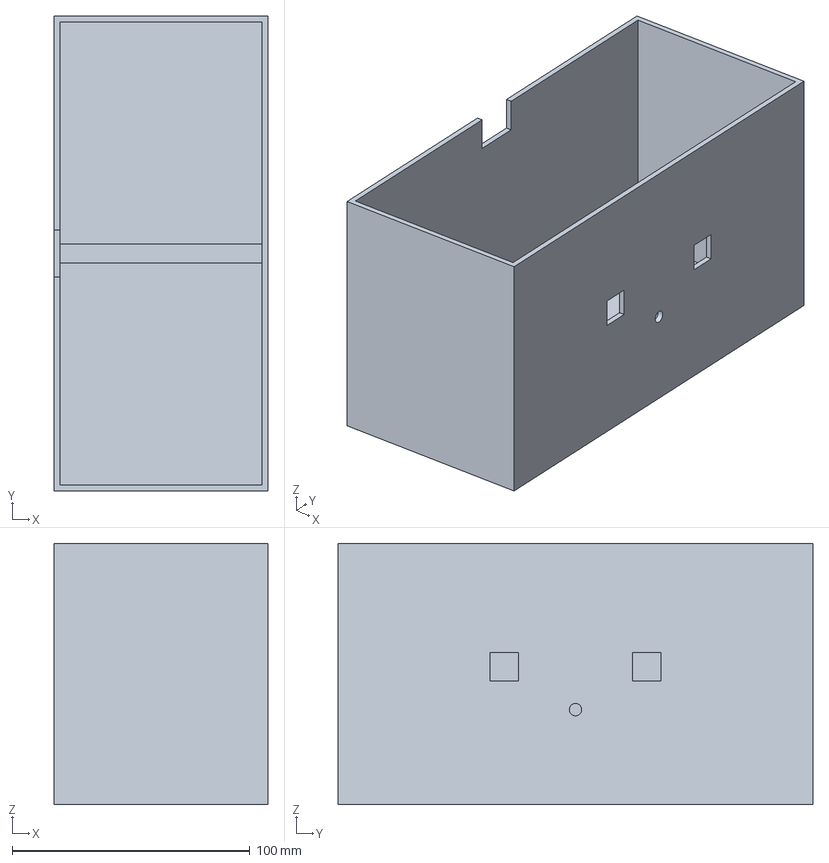
[picture p82: CAD file, 2026-10-17]
bot_3d_printing/step/dock_station.step
90.0 x 200.0 x 110.0 mm
