Gurjas2112/CHOTU/bot_3d_printing/step/electronics_deck.step

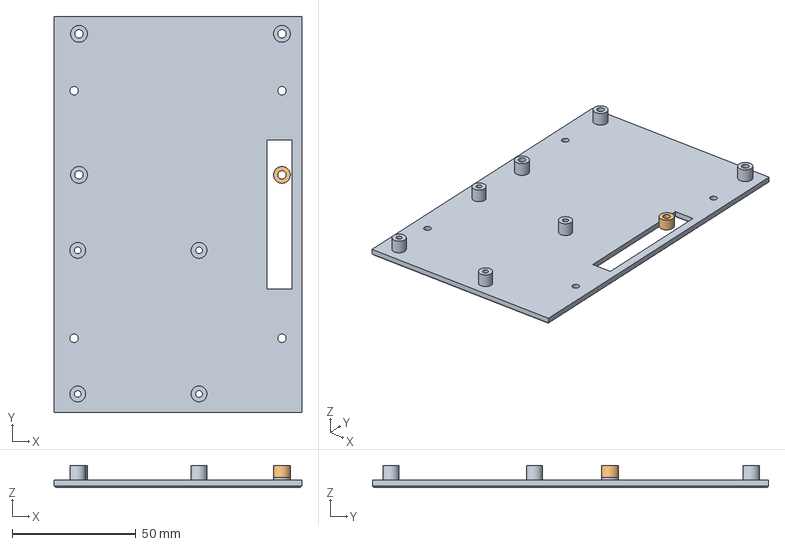
[picture p83: CAD file, 2026-10-17]
bot_3d_printing/step/electronics_deck.step
100.0 x 160.0 x 9.00 mm
