Gurjas2112/CHOTU/bot_3d_printing/step/suction_nozzle.step

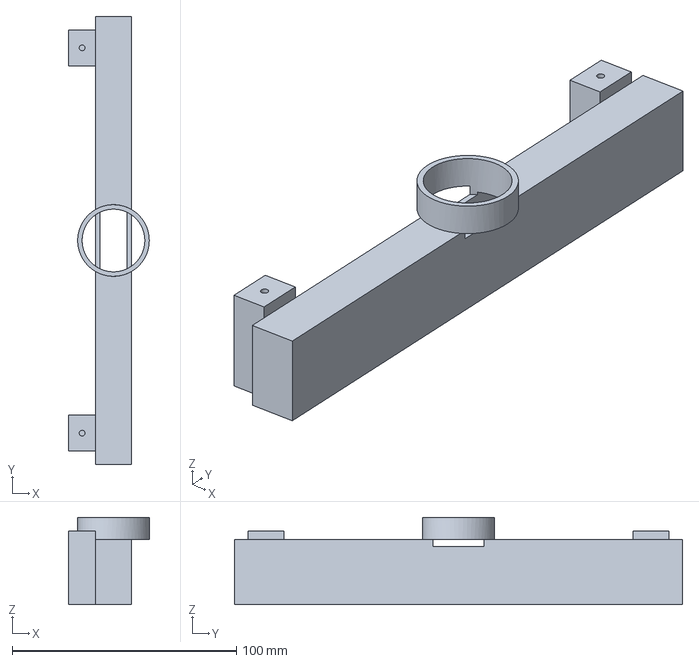
[picture p84: CAD file, 2026-10-17]
bot_3d_printing/step/suction_nozzle.step
36.0 x 200.0 x 39.0 mm
