Gurjas2112/CHOTU/bot_3d_printing/step/rear_skid.step

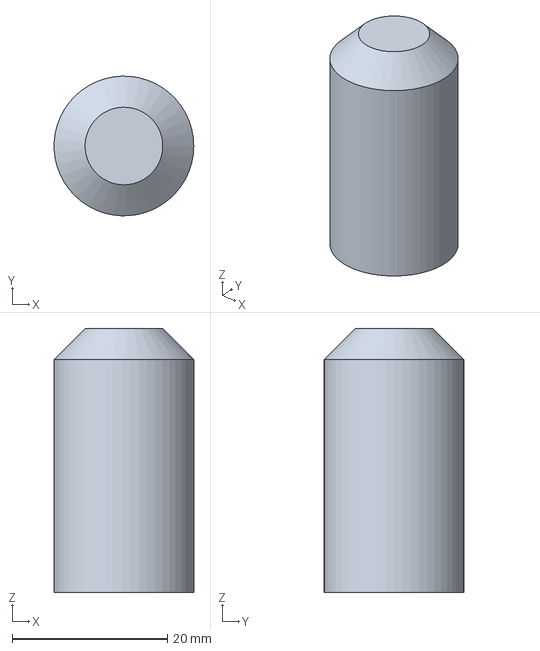
[picture p85: CAD file, 2026-10-17]
bot_3d_printing/step/rear_skid.step
18.0 x 18.0 x 34.0 mm
