Gurjas2112/CHOTU/bot_3d_printing/step/caster_spacer.step

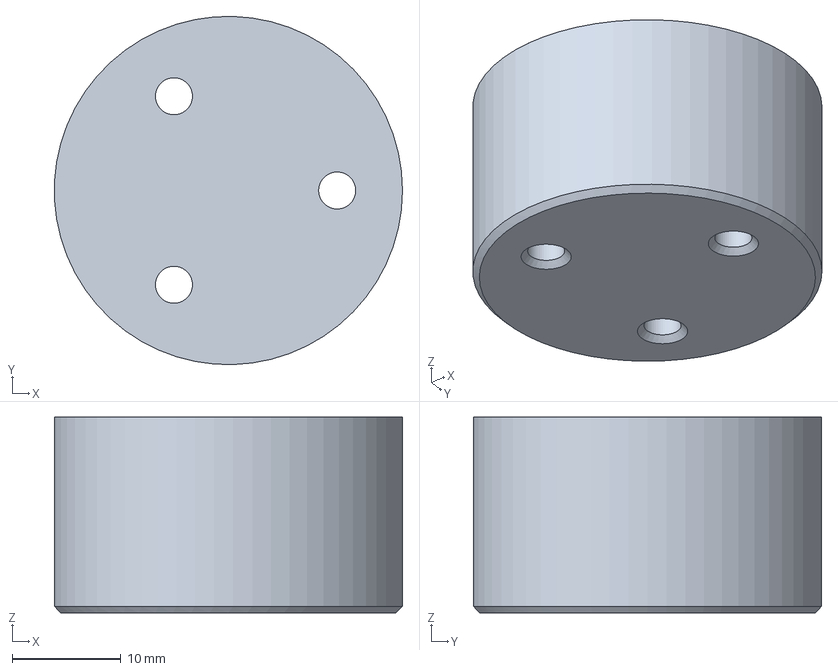
[picture p86: CAD file, 2026-10-17]
bot_3d_printing/step/caster_spacer.step
32.0 x 32.0 x 18.0 mm
