Gurjas2112/CHOTU/(list of files, cad)

Other CAD files:
bot_3d_printing/step/deck_pillar_1.step
bot_3d_printing/step/bumper_left.step
bot_3d_printing/step/deck_pillar_3.step
bot_3d_printing/step/cliff_mount_right.step
bot_3d_printing/step/deck_pillar_2.step
bot_3d_printing/step/bumper_right.step
bot_3d_printing/step/motor_bracket_right.step
bot_3d_printing/step/lid_tile_1.step
bot_3d_printing/stl/battery_tray.stl
bot_3d_printing/stl/bin_cradle.stl
bot_3d_printing/stl/bin_filter_lid.stl
bot_3d_printing/stl/bin_hatch.stl
bot_3d_printing/stl/bumper_front.stl
bot_3d_printing/stl/bumper_left.stl
bot_3d_printing/stl/bumper_rear.stl
bot_3d_printing/stl/bumper_right.stl
bot_3d_printing/stl/camera_pod.stl
bot_3d_printing/stl/caster_spacer.stl
bot_3d_printing/stl/cliff_mount_left.stl
bot_3d_printing/stl/cliff_mount_right.stl
bot_3d_printing/stl/deck_pillar_1.stl
bot_3d_printing/stl/deck_pillar_4.stl
bot_3d_printing/stl/dock_station.stl
bot_3d_printing/stl/dust_bin.stl
bot_3d_printing/stl/electronics_deck.stl
bot_3d_printing/stl/lid_tile_1.stl
bot_3d_printing/stl/lid_tile_2.stl
bot_3d_printing/stl/lid_tile_3.stl
bot_3d_printing/stl/lid_tile_4.stl
bot_3d_printing/stl/motor_bracket_left.stl
bot_3d_printing/stl/motor_bracket_right.stl
bot_3d_printing/stl/rear_skid.stl
bot_3d_printing/stl/side_brush_mount.stl
bot_3d_printing/stl/suction_nozzle.stl
