Gurjas2112/CHOTU/bot_3d_printing/dxf/mdf_base_holes.csv

x_mm | y_mm | diameter_mm | purpose
-136.5 | -44.3 | 3.4 | M3 for bumper_rear
-136.5 | 44.3 | 3.4 | M3 for bumper_rear
-128 | 0 | 3.4 | M3 for rear_skid
-107.0 | -50.0 | 3.4 | M3 for deck_pillar_1
-107.0 | 50.0 | 3.4 | M3 for deck_pillar_2
-65.0 | -13.8 | 3.4 | M3 for battery_tray
-65.0 | 13.8 | 3.4 | M3 for battery_tray
-44.3 | -136.5 | 3.4 | M3 for bumper_right
-44.3 | 136.5 | 3.4 | M3 for bumper_left
-23.0 | -50.0 | 3.4 | M3 for deck_pillar_3
-23.0 | 50.0 | 3.4 | M3 for deck_pillar_4
-2.0 | -122.0 | 3.4 | M3 for motor_bracket_right
-2.0 | -84.0 | 3.4 | M3 for motor_bracket_right
-2.0 | 84.0 | 3.4 | M3 for motor_bracket_left
-2.0 | 122.0 | 3.4 | M3 for motor_bracket_left
25.0 | -52.8 | 3.4 | M3 for bin_cradle
25.0 | 52.8 | 3.4 | M3 for bin_cradle
44.3 | -136.5 | 3.4 | M3 for bumper_right
44.3 | 136.5 | 3.4 | M3 for bumper_left
46.0 | -86.0 | 3.4 | M3 for suction_nozzle
46.0 | 86.0 | 3.4 | M3 for suction_nozzle
90.0 | -82.0 | 3.4 | M3 for side_brush_mount
95.0 | -52.8 | 3.4 | M3 for bin_cradle
95.0 | 52.8 | 3.4 | M3 for bin_cradle
110.0 | -82.0 | 3.4 | M3 for side_brush_mount
112.0 | -72.0 | 3.4 | M3 for cliff_mount_right
112.0 | 72.0 | 3.4 | M3 for cliff_mount_left
120.0 | -8.7 | 3.4 | M3 for caster_spacer
120.0 | 8.7 | 3.4 | M3 for caster_spacer
135.0 | 0.0 | 3.4 | M3 for caster_spacer
136.5 | -44.3 | 3.4 | M3 for bumper_front
136.5 | 44.3 | 3.4 | M3 for bumper_front
60.0 | 0 | 33.0 | suction duct
