Gurjas2112/CHOTU/bot_3d_printing/previews/battery_tray_4view.png

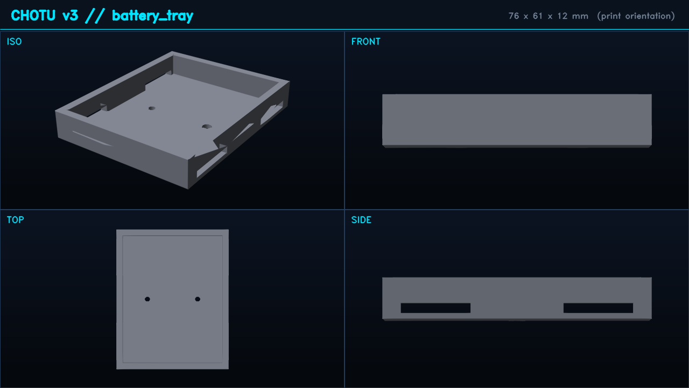
bot_3d_printing/previews/battery_tray_4view.png
