Gurjas2112/CHOTU/bot_3d_printing/previews/bin_cradle_4view.png

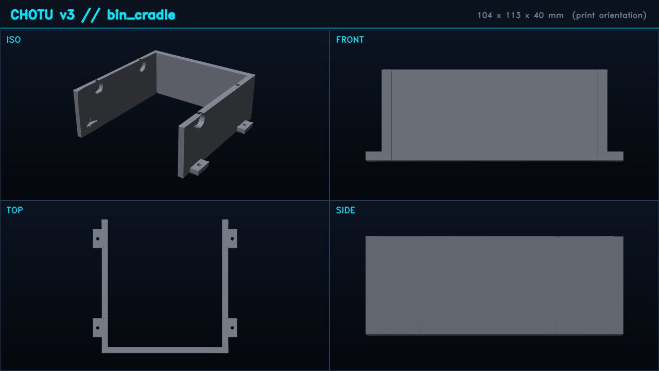
bot_3d_printing/previews/bin_cradle_4view.png
