Gurjas2112/CHOTU/bot_3d_printing/previews/bin_filter_lid_4view.png

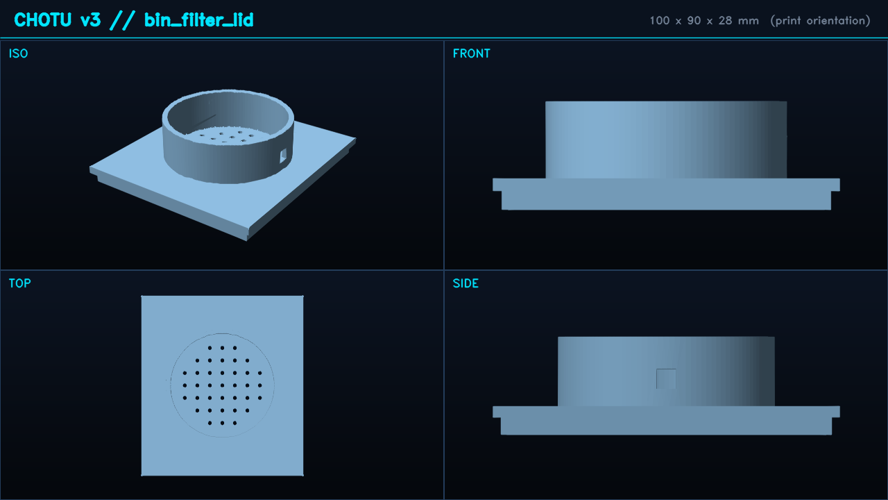
bot_3d_printing/previews/bin_filter_lid_4view.png
