Gurjas2112/CHOTU/bot_3d_printing/previews/bin_hatch_4view.png

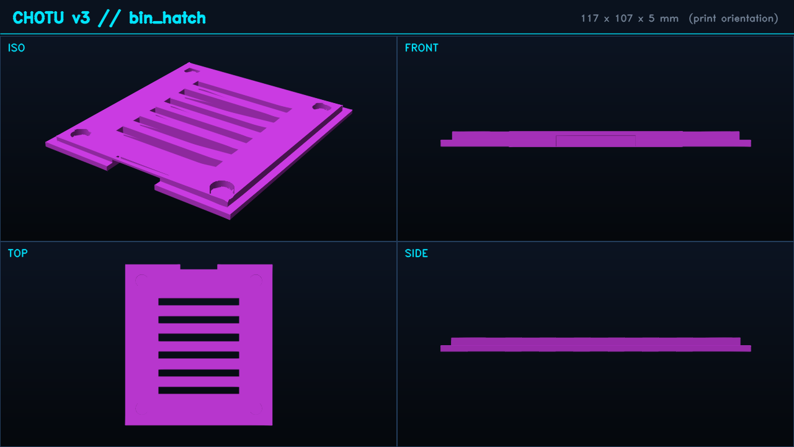
bot_3d_printing/previews/bin_hatch_4view.png
