Gurjas2112/CHOTU/bot_3d_printing/previews/bumper_right_4view.png

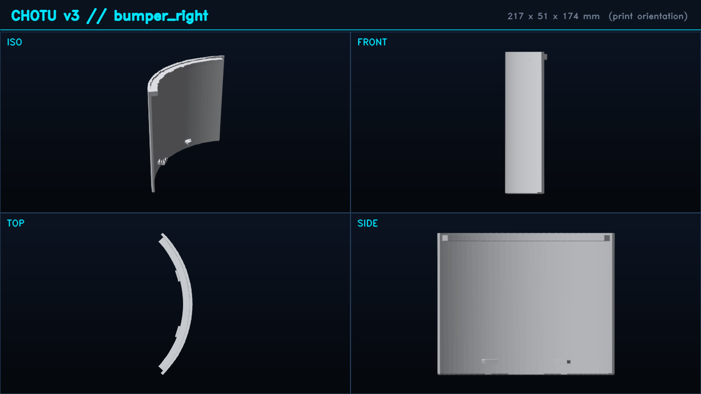
bot_3d_printing/previews/bumper_right_4view.png
