Gurjas2112/CHOTU/bot_3d_printing/previews/camera_pod_4view.png

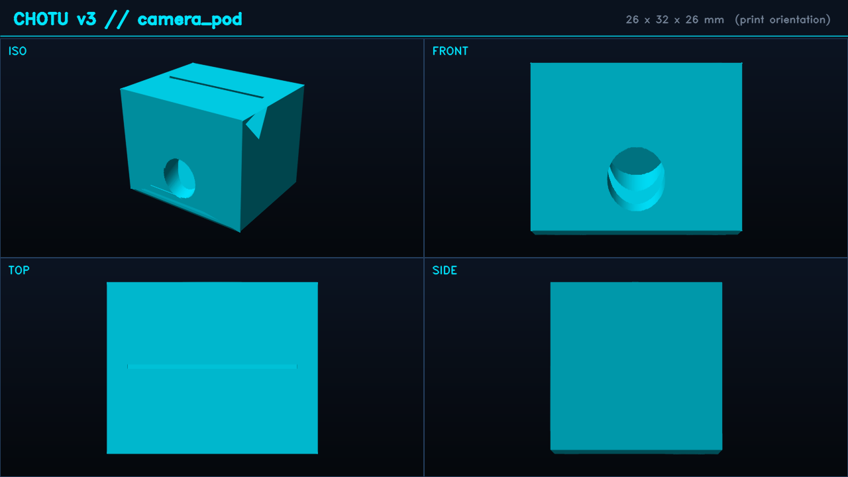
bot_3d_printing/previews/camera_pod_4view.png
