Gurjas2112/CHOTU/bot_3d_printing/previews/cliff_mount_left_4view.png

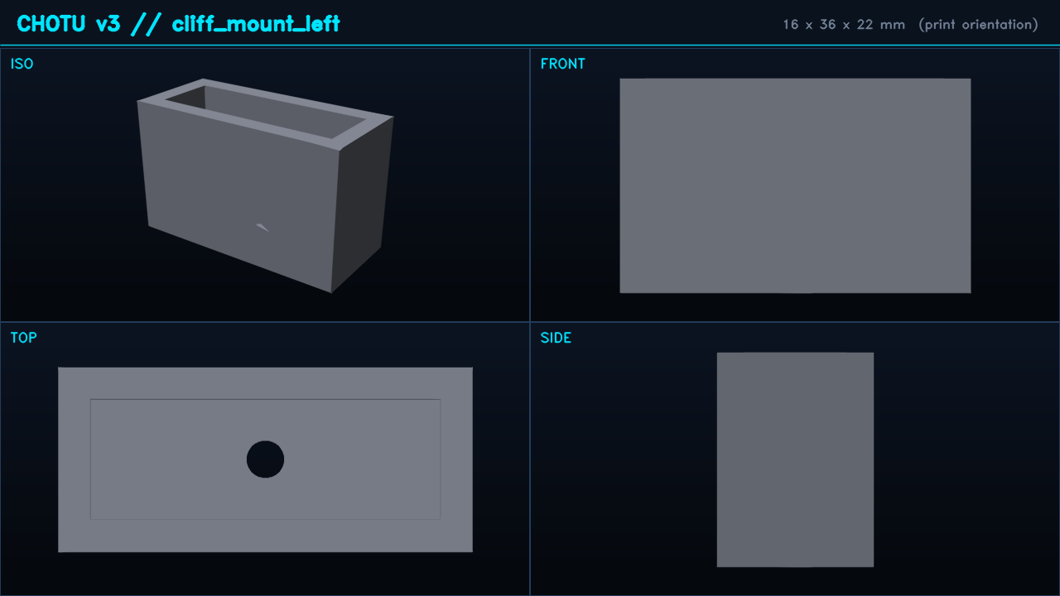
bot_3d_printing/previews/cliff_mount_left_4view.png
