Gurjas2112/CHOTU/bot_3d_printing/previews/deck_pillar_1_4view.png

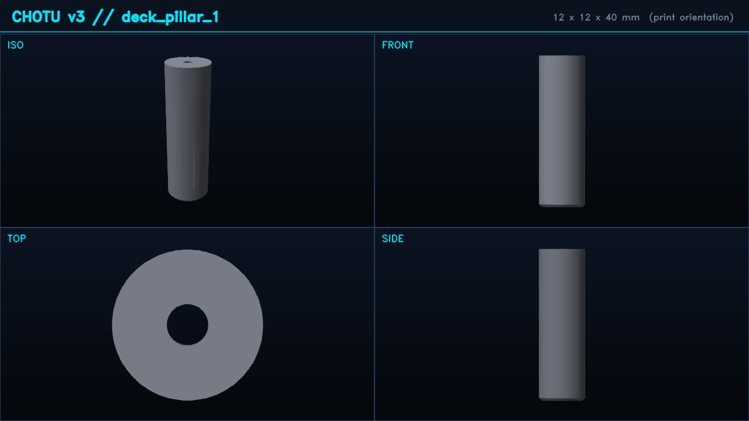
bot_3d_printing/previews/deck_pillar_1_4view.png
