Gurjas2112/CHOTU/bot_3d_printing/previews/dock_station_4view.png

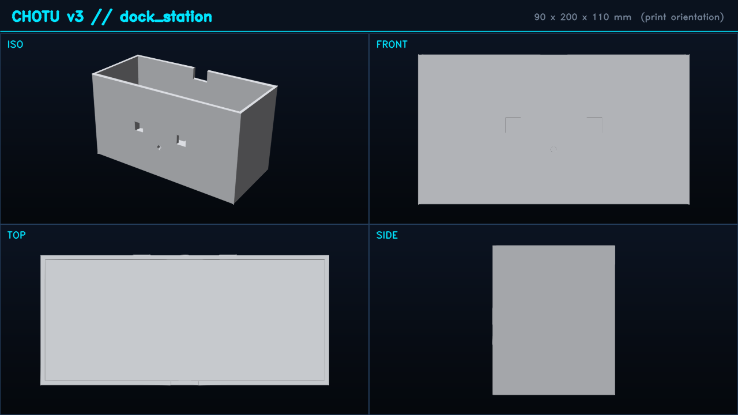
bot_3d_printing/previews/dock_station_4view.png
