Gurjas2112/CHOTU/bot_3d_printing/previews/lid_tile_3_4view.png

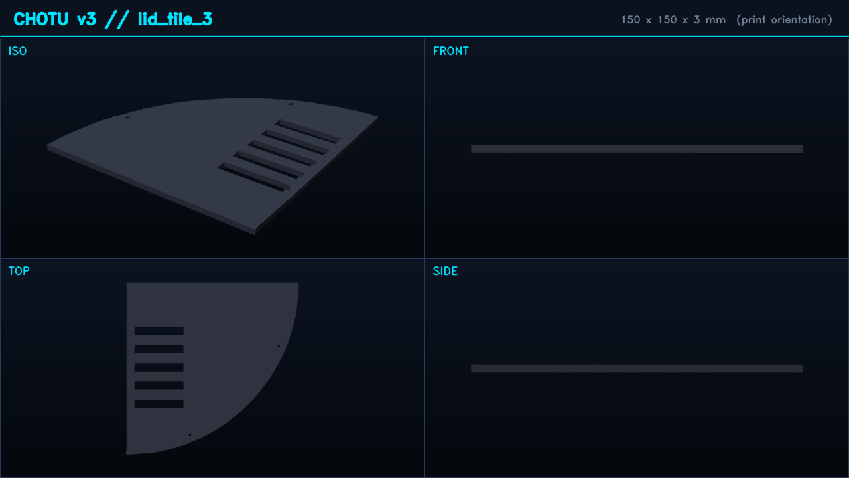
bot_3d_printing/previews/lid_tile_3_4view.png
