Gurjas2112/CHOTU/bot_3d_printing/previews/lid_tile_4_4view.png

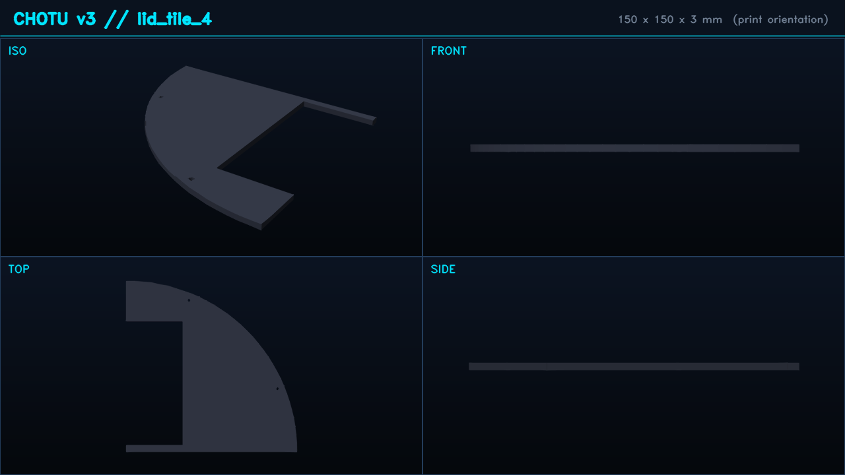
bot_3d_printing/previews/lid_tile_4_4view.png
