Gurjas2112/CHOTU/bot_3d_printing/previews/motor_bracket_left_4view.png

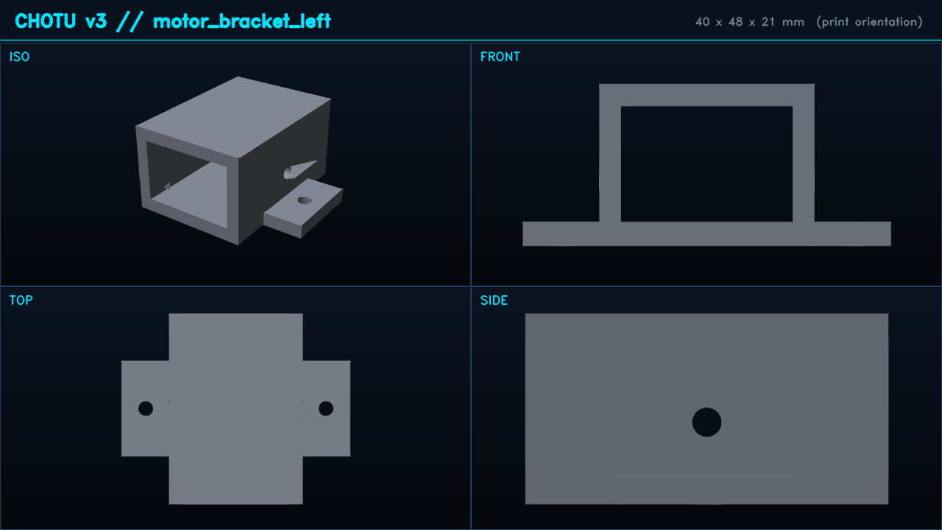
bot_3d_printing/previews/motor_bracket_left_4view.png
