Gurjas2112/CHOTU/bot_3d_printing/previews/suction_nozzle_4view.png

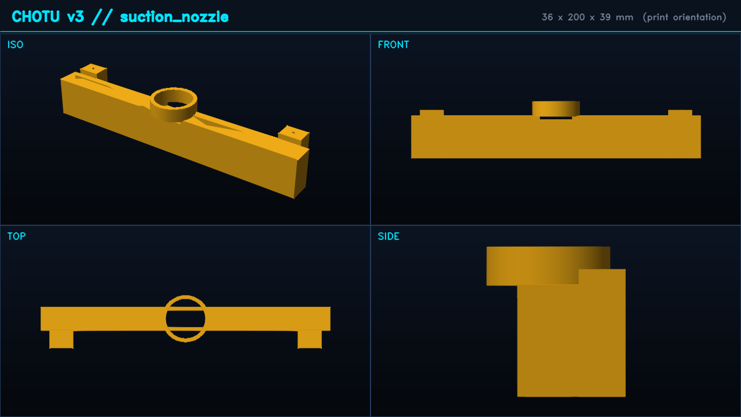
bot_3d_printing/previews/suction_nozzle_4view.png
