Gurjas2112/CHOTU/docs/TESTING.md

# Testing Strategy

Testing runs from cheapest to most realistic. Every layer is automated except the physical acceptance test.

```
L1 unit (pytest, g++, flutter test)  ->  L2 Gazebo end-to-end mission  ->  L3 ROS 2 build/test (colcon)  ->  L4 Gazebo  ->  L5 HIL bench  ->  L6 AtomQuest acceptance run
```

## L1. Unit tests

### Python: `tests/` (pytest, about 90 s including end-to-end)
```bash
python -m pytest tests -q
```
| File | Covers |
|---|---|
| `test_protocol.py` | CRC16-CCITT check value `0x29B1`, COBS vectors, framing, stream decoder, corruption rejection, telemetry layout (25 B) |
| `test_kinematics.py` | Wrap-angle, diff-drive inverse, arc integration, encoder odometry |
| `test_mapping_planning.py` | Ray integration, wall-echo rejection, wall band, dilation, A* detour and unreachable cases, boustrophedon serpentine, frontier pockets |
| `test_behaviour.py` | Safety levels, side-wall corridor rule, FSM legal and illegal transitions, adaptive suction, battery (pitch numbers), scoring, perception projection and mock detector, no-go zone planning |
| `test_pcb_netlist.py` | Carrier PCB: every `pins.h` GPIO matches the PCB net, design-rule check, IRLZ44N/1N5822/TB6612 STBY pull-down, 5 V dividers, battery sense below 3.1 V |

### Fleet backend: `backend/tests` (pytest, about 2 s)
```bash
python -m pytest backend/tests -q
```
The same API tests run against the **sample store** and the **SQL store**; the SQL store uses in-memory SQLite seeded from `sample_data`. The suite also covers the WebSocket protocol, the API-key guard, the rosbridge translation (checked against the `.msg`/`.srv` field names), and `RosbridgeRobotLink` against a fake rosbridge server. It checks that `migrations/001_init.sql` matches the ORM column by column. The PostgreSQL path was also run for real (`docker compose --profile db`): schema from the migration, seed, reads and writes.

### Mobile app: `mobile_app/chotu_app/test` (flutter test)
```bash
cd mobile_app/chotu_app && flutter analyze && flutter test
```
It covers rosbridge JSON builders, backend JSON parsing (with a mock HTTP client), and widget flows: connect, clean, no-go zone.

### C++ firmware logic: `firmware/esp32s3_base_controller/test_host` (322 checks)
```powershell
# Windows PowerShell / cmd (MSYS2 UCRT64 g++ 16.2)
cd firmware\esp32s3_base_controller\test_host
g++ -std=c++17 -O2 -Wall -Wextra -Werror "-I../lib/chotu_logic/src" test_chotu_logic.cpp -o test_chotu_logic.exe
.\test_chotu_logic.exe          # -> chotu_logic host tests: 322 passed, 0 failed
```
```bash
make -C firmware/esp32s3_base_controller/test_host   # Linux / CI
```
The Python and C++ suites assert the **same byte vectors**, generated by `chotu_core/protocol.py`. That proves the firmware and the ROS bridge agree on the wire format.

> Git Bash note: the MSYS2 UCRT64 `g++` can fail silently from Git Bash's MSYS environment. Use PowerShell, cmd or the MSYS2 UCRT64 shell.

## L2. End-to-end mission in Gazebo

`bot_simulation/gazebo_recording/run_gazebo_recording.sh` builds the workspace and launches the full ROS 2 stack in Gazebo Fortress (headless). It records the mission until the robot reports `DOCKED`.

| Assertion | Result of the recorded run (`gazebo_mission_metrics.json`) |
|---|---|
| Robot returns to the dock | docked |
| Dock-to-dock time ≤ 300 s | 226.5 s |
| Coverage estimate | 97.9 % |
| Stuck recoveries | 0 |
| States visited | UNDOCK → SCAN → COVER → SPOT_CLEAN → RETURN_TO_DOCK → DOCKING → DOCKED |

## L3. ROS 2 build and tests (Docker or WSL)
```bash
bash scripts/build_ros_docker.sh
# = rosdep install + colcon build --symlink-install + colcon test --packages-select chotu_base
```
Checks after the build:
```bash
ros2 interface show chotu_interfaces/msg/CleaningStatus
ros2 launch chotu_description description.launch.py rviz:=true     # model renders, TF tree ok
xacro ros2_ws/src/chotu_description/urdf/chotu.urdf.xacro > /tmp/chotu.urdf && check_urdf /tmp/chotu.urdf
```

## L4. Gazebo integration
```bash
ros2 launch chotu_bringup sim.launch.py rviz:=true vision:=false
ros2 topic hz /range/center          # ~17 Hz
ros2 topic echo /chotu/status --once # state progresses UNDOCK -> SCAN -> COVER ...
ros2 run tf2_tools view_frames       # odom -> base_footprint -> base_link -> sensors
```
Pass criteria: the robot leaves the dock, builds `/map` (view it in RViz), never touches the walls or box and bin models, and returns to the dock before T+300 s.

## L5. Hardware-in-the-loop bench (robot on blocks)

| Step | Command / action | Expected |
|---|---|---|
| 1 Link | `ros2 topic hz /odom` | 50 Hz, no CRC warnings |
| 2 Watchdog | Stop the bridge container | Wheels and vacuum stop within 0.3 s, watchdog flag set |
| 3 Wheel PID | `ros2 topic pub /cmd_vel geometry_msgs/Twist "{linear: {x: 0.2}}" -r 10` | Wheel speed from /odom 0.2 ± 0.02 m/s |
| 4 Sensors | Hand at 20 cm in front of each sensor | `/range/*` reads 0.20 ± 0.02 m |
| 5 Safety | Hand at 4 cm in front, then cmd_vel forward | Firmware refuses forward motion |
| 6 Bump | Tap the chassis | `/chotu/bump` true for one cycle |
| 7 Suction | `ros2 topic pub /chotu/actuators chotu_interfaces/msg/Actuators "{suction: 0.55, brush: 1.0}"` | Vacuum in ECO, no brown-out on the Pi |
| 8 Camera | `ros2 topic echo /chotu/detections` with a cable in view | `power_cable`, action `avoid` |

## L6. Acceptance: AtomQuest dry run on the real floor

1. Build a 10 ft × 10 ft area with 2 boxes, 1 chair, 1 bin and 1 cable, and place the dock on the south wall.
2. Weigh the garbage per type (dust, paper, hair, wrappers, wire strands) and scatter it.
3. Start the mission with the `/chotu/start_mission` service and the stopwatch together.
4. Record: docked yes/no, time, collisions, restarts, and the collected mass per type (weigh the container contents).
5. Compute the score with `chotu_core.scoring.score(RunResult(...))` and compare it with the Gazebo run of the same layout. If the coverage error is above 10 %, recalibrate the Gazebo model (wheel friction in `chotu.urdf.xacro`, sensor noise in the world SDF).

## CI (`.github/workflows/ci.yml`)
| Job | What |
|---|---|
| python-core-and-pcb | pytest: autonomy, protocol, mapping/planning, behaviour, PCB-vs-firmware pin check |
| firmware | host tests (make) + **PlatformIO build for the ESP32-S3** (real cross-compile) |
| ros2-humble | `ros:humble-ros-base` container: rosdep + colcon build + colcon test |
| backend | pytest on the FastAPI service (sample + SQL stores) |
| mobile-app | `flutter analyze` + `flutter test` |

## Results recorded for this release (v3.0.0)

| Check | Result |
|---|---|
| `pytest tests` (core + PCB ↔ firmware) | 32 passed |
| `pytest backend/tests` (sample + SQL stores, WebSocket, auth, migration, rosbridge link) | 23 passed |
| `flutter analyze` / `flutter test` | no issues / 11 passed |
| Firmware host tests (g++ 16.2, `-Wall -Wextra -Werror`) | 322 passed, 0 failed |
| PostgreSQL 16 end to end (`docker compose --profile db`) | schema from `001_init.sql`, seeded 4 robots / 40 missions, API reads and writes the db |
| App ↔ backend (web build + live API) | History tab rendered chotu-01's missions from `GET /api/v1/missions` |
| Docker `chotu/dev:3.0.0` + `colcon build` (7 packages) | built |
| Gazebo Fortress mission (headless) | docked at 226.5 s, coverage estimate 97.9 %, 0 recoveries |
| CAD pipeline | 28/28 printed parts pass the FDM review; walkthrough MP4 decodes with 0 errors |
| PCB design-rule check | 54 parts, 45 nets, 0 errors |
| PlatformIO cross-compile | runs in CI (PlatformIO is not installed on the development PC) |
