Gurjas2112/CHOTU/bot_simulation/simulation_screenshot_screen_recording/benchmark_10_rooms_and_vision_ablation.png

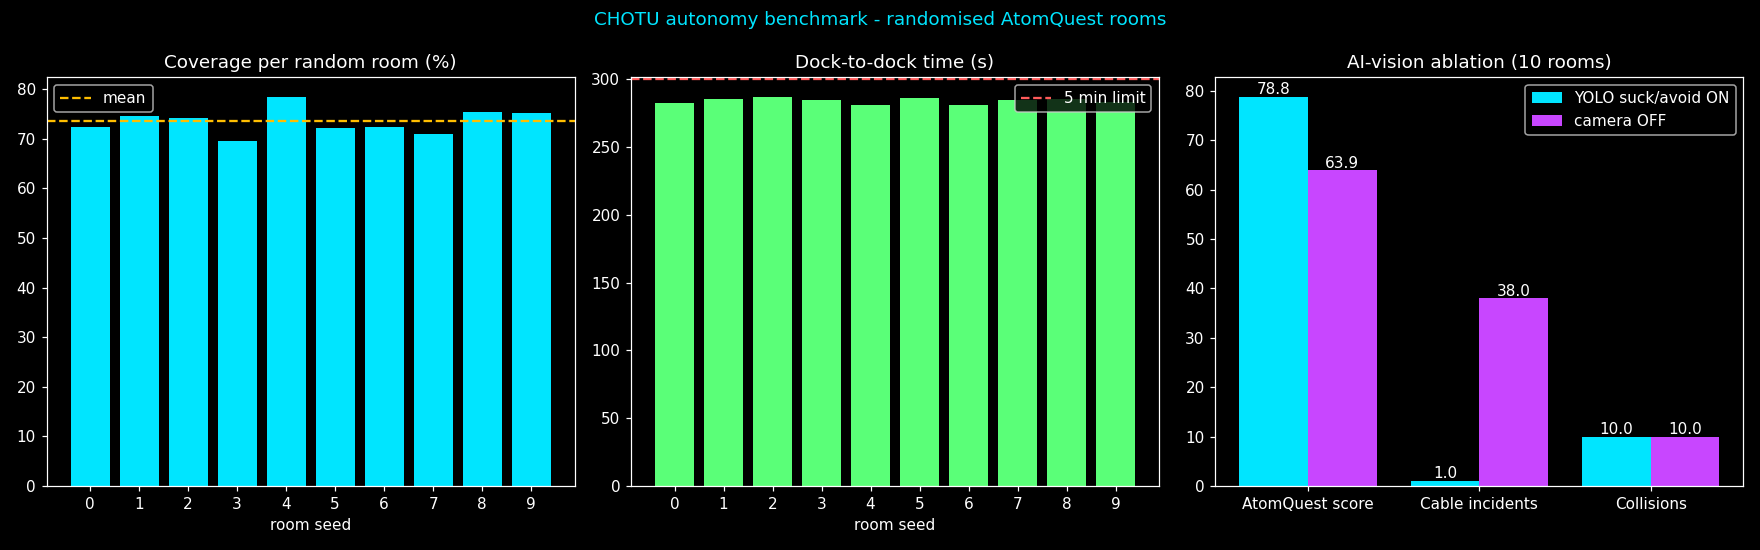
bot_simulation/simulation_screenshot_screen_recording/benchmark_10_rooms_and_vision_ablation.png
