Gurjas2112/CHOTU/backend/docs/app_history_from_backend.png

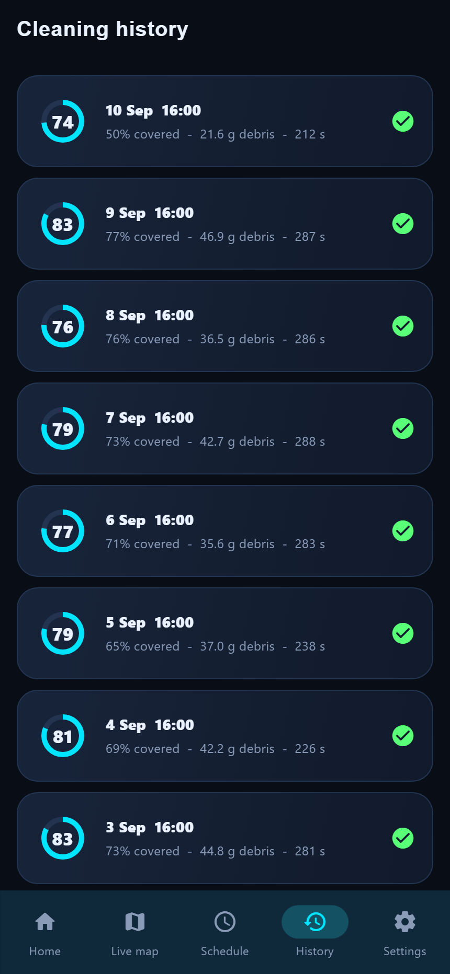
backend/docs/app_history_from_backend.png
