Gurjas2112/CHOTU/mobile_app/app_screenshot_screen_recording/15_cleaning_history.png

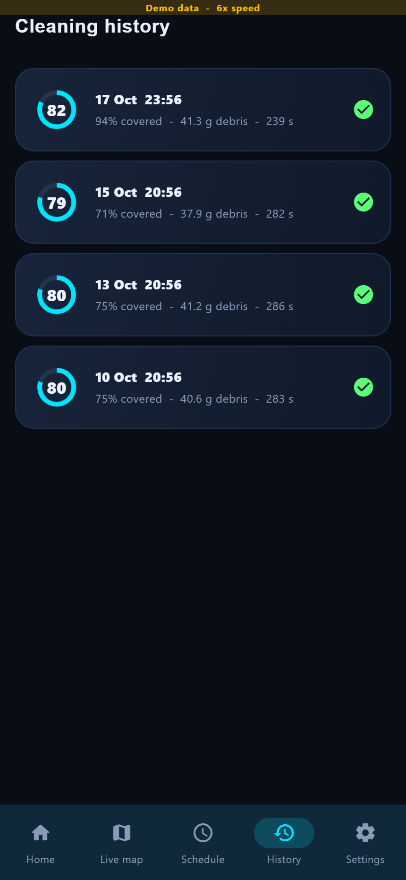
mobile_app/app_screenshot_screen_recording/15_cleaning_history.png
