Gurjas2112/CHOTU/(commit log)

2026-10-17 CHOTU v2: autonomous robot stack, digital twin, firmware, ROS 2 and docs
    - chotu_core: shared autonomy library (mapping, boustrophedon coverage,
    A* return-to-dock, reactive safety, mission FSM, adaptive suction,
    YOLOv8n suck/avoid perception, Pi<->ESP32 protocol, AtomQuest scoring)
    - bot_simulation: digital twin driving the real mission code, futuristic
    HUD, fleet dashboard, benchmarks, flow-wise screenshots and recordings
    - firmware: ESP32-S3 base controller (PID, sensors, safety watchdog) with
    g++ host tests sharing byte vectors with the Python protocol
    - ros2_ws: Humble packages (interfaces, description, base bridge,
    navigation, perception, bringup, Gazebo world)
    - docker/devcon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
2026-10-17 CHOTU v3: structured repo, fleet backend, Gazebo-only simulation, PCB, CAD, Flutter app
    Repository structure
    - Engineering docs moved from essential_docs/ to docs/; essential_docs/ keeps the
    original AtomQuest 2025 material
    - bot_simulation/ now holds only the Gazebo Fortress mission recording; the Python
    digital twin, its recordings, e2e tests, run_sim.bat and Dockerfile.sim are removed
    - App screenshots/recording live in mobile_app/app_screenshot_screen_recording/
    - Generated by-products removed (SKiDL REPL/ERC/log/sklib, IDE files, caches);
    .gitignore, .gitattributes, requirements-dev.txt added
    - Recruiter-facing README: skills-to-evidence map, measurable results, media gallery
    Fle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
2026-10-17 Rename essential_docs/ to old_essential_docs/
    The original AtomQuest 2025 material (problem statement, spec sheet, bills,
    photos, research papers) now lives in old_essential_docs/. All references in
    the README, docs, PCB source, chotu_core and the perception training script
    are updated; markdown links checked (0 broken), pytest 55 passed.
2026-10-17 Real-robot integration guides + fixes found while rehearsing against Gazebo
    Docs
    - backend/REAL_ROBOT_INTEGRATION.md: step-by-step path from printed parts to
    stored mission data (mechanical, carrier PCB J1-J18, firmware, Pi + udev,
    Docker deploy, YOLO train/export, Gazebo rehearsal, connection checklist,
    retrieval/storage design, troubleshooting); each step marked verified,
    on-hardware or to-add
    - mobile_app/REAL_ROBOT_CONNECTION.md: demo / direct / direct+backend modes,
    APK build, connect, commands, storage, troubleshooting
    Verified: backend in rosbridge mode against the Gazebo robot (live telemetry,
    set_zones applied, return_to_dock -> DOCKED 2.8 cm from the dock pose) and the
    F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
